DroneAid-Parts/OpenAIO/research/review-2026-10/lr_img/base_inner.png

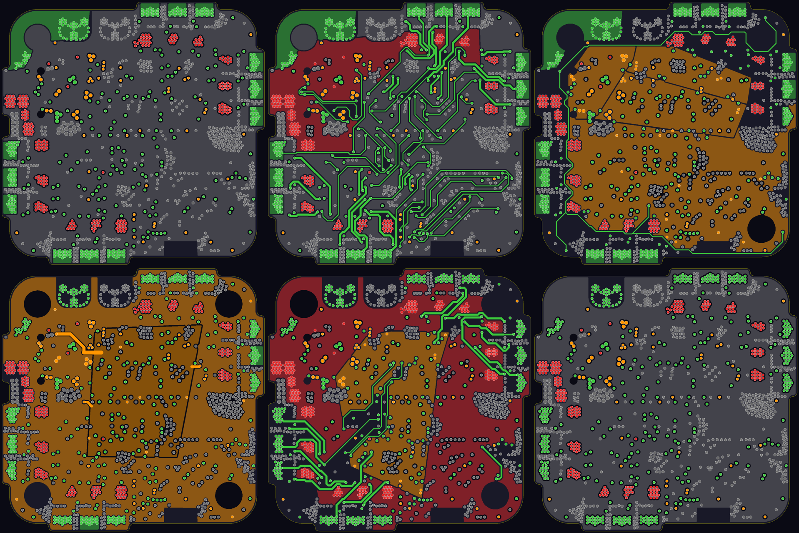
research/review-2026-10/lr_img/base_inner.png
