DroneAid-Parts/OpenAIO/research/review-2026-10/lr_img/core_all.png

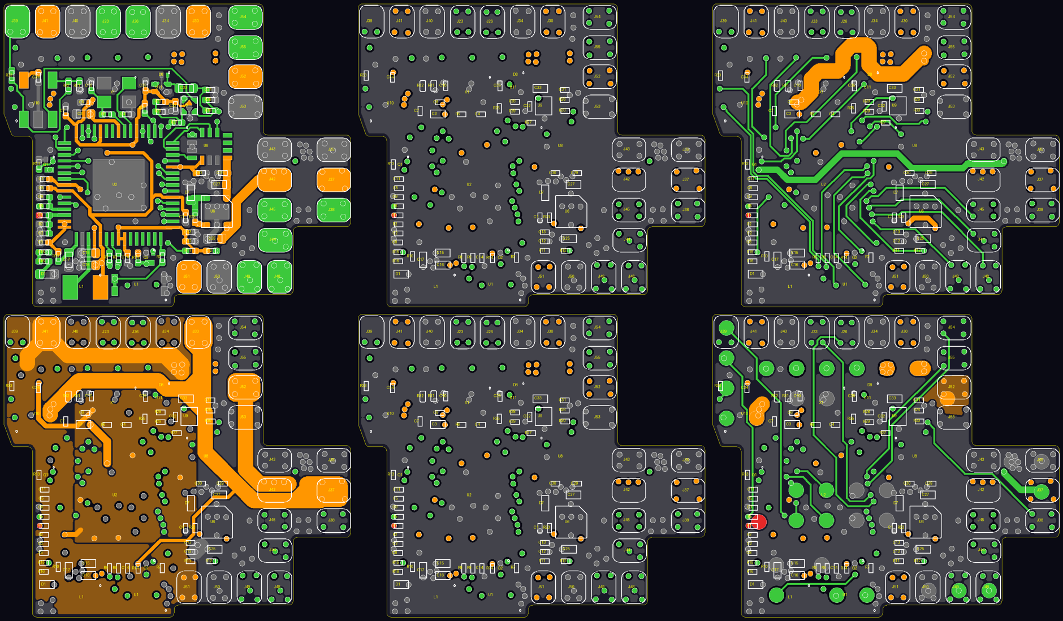
research/review-2026-10/lr_img/core_all.png
