DroneAid-Parts/OpenAIO/research/review-2026-10/critique/round1/dfm.md

# OpenAIO critique round 1: DFM and assembly (perspective: dfm)

Commit 1522ed6 (board files identical to f512434: `git diff --stat f512434 1522ed6 -- hardware` is empty). Both boards were refilled in a private copy with their own .kicad_pro and .kicad_dru. Scripts and outputs are in `scratchpad/critique/dfm/`: `dump.py`, `gaps.py`, `wrl.py` (exact VRML face projection), `paste.py`, `ep.py`, `tomb.py`, `lga.py`, `fid.py`, `edge.py`, `outside.py`, `under.py`, plus `out/drc_*.json`.

## Verdict

1. **Not orderable as is: 1 BLOCKER.** The TF socket Card1 stands under the Core's lower-left corner, so the Core cannot sit flat on J90.
2. **9 MAJOR problems block a clean NextPCB turnkey order**: FET land does not match the BOM MOSFET, fine-pitch stencil apertures too small, starved LGA joint, +BATT 0.16 mm from LGA signal pads, systematic 0201 tombstone risk, Core fiducials off-board, Core missing from the Base BOM/CPL, R34 under Card1, no legal tab sites for panelization.
3. **What passes:** fab rules (track/space, drill, ring, hole-to-hole, edge, VII fill+cap in board setup), BOM MPN coverage and second-side masses all pass apart from the known items.

Counts: BLOCKER 1, MAJOR 9, MINOR 12, NIT 3.

## Findings

| ID | severity | board/layer | location (ref, net, x,y) | evidence | fix |
|---|---|---|---|---|---|
| DFM-01 | BLOCKER | Base F + Core | Card1 (TF-021B-H265) at (67.72,65.92) r-90. The Core corner covers Base (69.19-70.82, 59.995-60.70), and the Core notch edge runs at x=70.77 for y 60.67-71.67 | Datasheet `TF-021B-H265.pdf` p.1-2: body 11.35±0.15 x 5.50±0.15 x 2.5 mm, with the 5.5 including a shell tab past the contact row. The placed `lib.3dshapes/TF-SMD_TF-021B-H265.wrl` has bbox x 65.32-70.82, y 59.995-71.345, z to 2.45. The Core outline maps to Base coordinates through the J91 to J90 offset (-34.232,+8.374); all 46 pads coincide with 0.000 mm error. Model faces above z 0.12 mm inside the Core outline: **1.03 mm² at the socket's pin-8 end, up to 1.64 mm deep**, plus 0.57 mm² along the notch (0.05-0.24 mm). The datasheet drawing puts the tab only 2.65-9.3 mm from the pin-8 end. Even then, the 4.6 mm main body ends at x≈69.92, while the Core corner sits at x 69.19-69.64, so the overlap is still 0.3-0.7 mm. The notch follows Card1's silk (x=69.25/70.14), which is drawn about 0.7 mm inside the real body. The Core floor sits about 0.05-0.07 mm above Base F. | Rework the corner. Options: move Card1 about 0.8 mm toward -x (pad 9 then needs USB1 nudged), or trim the Core corner and notch to clear the datasheet outline by ≥0.3 mm (Core U10 pads are about 0.5 mm from that corner). Then redraw the Card1 silk and courtyard from the datasheet, run `core_model.py`, and check the Base 3D view as AGENTS.md requires. |
| DFM-02 | MAJOR | Base F | R34 (FLASH_CS pull-up, 0201) at (69.975,70.90) | The socket model's underside faces (z -0.05) cover R34's whole body (0.24 mm² of face area over a 0.18 mm² body). By the datasheet, the main body edge at x≈69.92 still overlaps R34's body (x 69.825-70.125). The d81e559 review flagged this (LAYOUT_REVIEW 5.1) and it is unchanged. Card1 would rest on R34 and lift its contacts. | Move R34 ≥0.3 mm clear of the socket outline (x >71.1 is under the Core, so go -y or to B). |
| DFM-03 | MAJOR | Base F+B | All 24 Q (DOY180N03T), e.g. Q21 (88.67,58.53) F, Q16 (84.92,45.66) B | Footprint `Package_SON:Diodes_PowerDI3333-8`: drain land 1.71 x 2.37 mm main area, 0.75 mm from the source pads. BOM part `DOY180N03T.pdf` p.6, TDFN3333-8PL: EP L 2.75 x H 2.15, 0.35 mm (H1) from the source leads. **The land covers 69 % of the package EP on all 24.** The uncovered 0.40 mm strip on the source side lies over foreign copper under mask only: GND under the +BATT EP of Q21 (0.56 mm²), and GND (source) under the phase EP of 10 of the 12 low-side FETs (0.06-0.52 mm² each). | Draw a TDFN3333-8PL land from the datasheet (EP ≥2.15 x 2.75, about 0.35-0.40 mm to the source pads) and pull foreign pours out from under the EP. Alternatively, buy a real PowerDI3333-8 part. Regenerate the stencil. |
| DFM-04 | MAJOR | Core F, Base B | U2 RP2354A QFN-60 (110.71,55.52) Core. U13/U15/U17/U19 AT32F421 QFN-28 Base B | Board-level paste margin is -0.02 mm and -8 % **per axis**, and no fine-pitch footprint overrides it. A 0.2 mm pin pad therefore prints a 0.128 mm aperture: U2 0.695 x 0.128, AT32 0.422 x 0.128. At NextPCB's 0.10 mm stencil for 0.4 mm pitch, the area ratio is **0.54 (U2, 55 apertures) and 0.49 (AT32, 72 apertures)** against the IPC-7525 minimum of 0.66, and the aspect ratio is 1.28 against 1.5. Also below 0.55: Q1/Q2 DFN 0.51, D8 0.40, U11 0.42, FL1 0.53. The KiCad 0201s are fine because they carry their own paste pads (0.318 x 0.36, AR 0.84). EP coverage is 0.68-0.71. | Set the board paste ratio to 0 (keep -0.02 or 0), and put reductions only on EPs and large pads through footprint-level margins. For 0.4 mm-pitch pins use 1:1 apertures, which gives AR 0.78 at 0.10 mm. Recheck with `paste.py`. |
| DFM-05 | MAJOR | Base F J90 / Core B J91 | LGA, J90 origin (80.25,61.65); 46 pads at 1.0 mm diameter on a 2.0 mm pitch | J90 paste margin is -0.10 mm, giving a 0.80 mm aperture (64 % of the pad). J91 has no paste. Solder per joint at a 0.10 mm stencil is about 0.025 mm³ over a 0.785 mm² pad, so the joint is about **0.03 mm high**. The pad array diagonal is 23.3 mm, and IPC bow/twist of 0.75 % allows 0.17 mm across it. Core copper balance is F 72 % against B 86 % and In2 74 % against In3 81 %. The stackup sums to 0.90 mm (see DFM-16). A Core that bows by a few tens of µm leaves the corner joints open. | Print 1:1 or a 1.1:1 overprint on J90 with a 0.12-0.15 mm step stencil, or pre-bump J91 during the Core build. Put Core warpage ≤0.05 mm on the order (ask NextPCB), and balance the Core B pour. |
| DFM-06 | MAJOR | Base F.Cu (and Core B.Cu) | J90 pads 4 (+4v5), 8 (CURR), 10/20 (SWDIO/SWCLK), 12/13/17 (SPI0), 19/21/23/24 (MOTOR1-4), 22 (+5V), 25/33 (UART1), 34 (BUZZER-) | The +BATT F.Cu pour is **0.16 mm** from 15 non-GND LGA pads (29 pads under 0.3 mm in total). On the Core, the B.Cu GND pour is 0.105 mm from 25 J91 signal pads. Both sides have 0 mm mask expansion (see DFM-12), and a solder ball or mask sliver here cannot be seen or reworked. Decision D2 asked for ≥0.3 mm +BATT clearance around J90 and is not implemented. | Add a DRU rule: +BATT zone to J90 pads ≥0.30 mm (and GND to J91 signal pads ≥0.2). Refill, then rerun the DC solver. |
| DFM-07 | MAJOR | Core F, Base B | e.g. Core C10 (108.91,48.95): GND end has a via in pad and 0.77 mm² of pour, the other end 0.03 mm². Base C65 (84.83,76.40), C67 (90.69,71.80), R38 (67.35,61.53) | 0201 parts with a via in the pad at **one end only**: Core 30 of 43, Base 76 of 135. Of those, 15 (Core) and 33 (Base) also have ≥4x attached-copper asymmetry within 0.6 mm. 0402: 7 of 11 (Core) and 13 of 19 (Base). Pours connect pads solid (`connect_pads yes` on 3 of 4 Core zones and 43 of 48 Base zones), and the VII via ties the pad straight into the inner GND planes. This is a classic tombstone recipe. | For 0201/0402 GND pads use thermal-relief zone connection (pad-level override), or put a via in both pads, or dog-bone the GND via. Prioritise the 48 parts that have both conditions (`tomb.py`). |
| DFM-08 | MAJOR | Core F | FID1 (104.10,62.35), FID2 (124.30,61.60), FID3 (123.20,45.40) | All three Core fiducials are **outside Edge.Cuts**, 0.9 / 2.0 / 2.9 mm beyond the edge (their copper reaches 1.4-3.4 mm out). CAM will remove them, leaving 0 board fiducials for a 0.4 mm QFN-60, 0201s and two X2SON parts. DRC does not catch this because the copper is more than 0.2 mm from the edge. | Move the fiducials inside the outline: 3 asymmetric spots in the Core F free area (about 83 mm²), 1 mm copper with a 2 mm opening, ≥1 mm from copper. Panel fiducials alone are a fallback. |
| DFM-09 | MAJOR | Base BOM/CPL | J90 (80.25,61.65) | J90 is `exclude_from_bom` and `exclude_from_pos_files` (dump), and no other line stands for the Core. A turnkey Base order then has no BOM line or centroid for the Core PCBA. The Core's top is fully populated; U2 (the flattest pick surface) sits about 3.9 mm off the outline centre. | Add a BOM line "OpenAIO-Core PCBA (consigned, C)" plus a CPL row (J90 origin, rotation, side F) and a pick-point note. Confirm NEXTPCB.md question 4.6-1. |
| DFM-10 | MAJOR | Base and Core edges | Base perimeter 131.3 mm, Core 84.3 mm | NextPCB needs a panel (both boards are below the 50 x 50 minimum) with mouse-bite tabs ≥5 mm wide and parts ≥3 mm from a tab. Edge with no pad or body within 1.0 mm: **Base 2.2 mm in total (longest 1.25), Core 3.2 mm (longest 1.0)**. Within 0.5 mm: Base longest 2.75 mm at x=91.9, y 65.1-67.6; Core 11.75 mm on its bottom edge and 5.5 mm on the left diagonal. Other edge conditions: Base pads cross the edge on every side (DFM-22). USB1 overhangs 1.1 mm (model) and U12 0.49 mm. B-side Q16/Q26/Q20/Q8/Q10 bodies are 0.09-0.19 mm from the edge and FL1 0.01 mm. Core R13 is 0.24 mm and Core edge pads line 3 sides. Base F parts sit 0.34-0.45 mm from the Core outline (JP1, C105/C106, U12, Q21, Q13), which leaves no room for mouse-bite nubs on those Core edges. | Agree the panel with NextPCB before ordering: tabs only at the measured free runs (Core bottom and diagonal; Base right edge x=91.9), solid frame and post-assembly router depanel, or a KiKit panel with a slot ≥2.5 mm at USB1. Sand the Core nubs facing JP1, C105/C106 and Q13/Q21. |
| DFM-11 | MINOR | Base F | L3 (66.675,54.125) / U25 (67.15,51.55); C104 (67.75,50.15) | This pair and R34/Card1 are the source of the reported "F P10 0.000". L3 is 3.0±0.1 (`XRTC303020D4R7MBCA.pdf` §3) and U25 is SC70 2.00 x 1.25 nominal (`INA186A3IDCKR.pdf`). Nominal edges: L3 at y=52.625, U25 at y=52.55, a **0.075 mm** body gap. At maximum tolerance they overlap by about 0.05 mm (model overlap 0.027 mm²). | Move U25 and C104 0.2 mm toward -y (or L3 toward +y). |
| DFM-12 | MINOR | Both, mask | Board setup | `pad_to_mask_clearance 0` on both boards. NextPCB asks for ≥0.04 mm expansion, so its CAM will grow the openings. The Core has no `solder_mask_min_width` (Base has 0.09). With 0.04 / 0.09 set: Core loses the dams on U9 (5) and U11 (4); Base on U23 (2), C19-U25, R64/R65/R66/C45, R57-R83, and FID1/FID2 openings touch neighbouring pads. | Set the mask web to 0.09 on the Core and the expansion to 0.04-0.05 on both, then rerun DRC. Gang U9/U11/U23 deliberately and say so in the order. |
| DFM-13 | MINOR | Core F, Base B | Core C32-U9 0.150, R13-Q1 0.17, U6-R23 0.189, C5-C9/C8-C2 0.195. Base B R20-Rsense2 0.128, R65/R66/R64/C45 0.155, 25 0201 pairs at 0.175 | Fab-body nearest-neighbour gaps: Core F median 0.230 / P10 0.189, 8 real pairs under 0.20 (C34-U10 0.000 is a false positive: lead-to-body 0.4-0.6 mm). Base B median 0.325 / P10 0.175, 32 pairs under 0.20. NextPCB's 0201 guidance is 0.20-0.25, so expect DFA questions. | Accept them in the DFA review or open the 0.128-0.155 pairs to ≥0.20 (R20 against the 2512, the R64-R66 cluster). |
| DFM-14 | MINOR | Base F, B / LGA | J90 area | 2D X-ray: 37 of 46 LGA joints overlap other solder in plan, 21 from Base B parts (U15/U16/U17/U19/U20/U21, D2-D4) and 28 from Core F parts (U2 EP, U8, U6, X1, ...). NextPCB's default 2D X-ray cannot resolve them. | Ask for 2.5D or oblique AXI on first articles and add a firmware test that toggles all 46 LGA nets (SWD is on the LGA). |
| DFM-15 | MINOR | Base F, Core B silk | J90 pin-1 circle 0.13 mm², Card1 silk lines, "-" label at (71.0,53.6), J91 B.Silkscreen circle | Silk ink (10-20 µm) under the Core, against a joint about 30 µm high (DFM-05). | Delete silk inside the Core outline on Base F and all silk on Core B. |
| DFM-16 | MINOR | Core stackup | Board setup | The board says 0.8 mm, but the stackup sums to **0.90 mm** (inner Cu 0.035 = 1 oz; JLC dielectrics 0.0994/0.11/0.25). The Core DRU assumes NextPCB `6L-0.8mm-0.5oz-1080` with 0.5 oz inner: its 0.076 inner rule is invalid at 1 oz, and NextPCB publishes no 1 oz inner at 0.8 mm. | Enter the NextPCB 6L-0.8 stack (0.5 oz inner) or fix the DRU. Order a customer-specified stack for the Base (non-standard 0.1/0.3 pairing; NEXTPCB.md 1.1). |
| DFM-17 | MINOR | Both | Stackup `copper_finish "None"` | Finish is unspecified. HASL is not flat enough for 0.4 mm QFN, 0201, the X2SONs and a thin-joint LGA. | Set ENIG in both stackups and on the order. |
| DFM-18 | MINOR | Base F | L2 (66.665,57.65), L3 | `lib.pretty/IND-SMD_L3.0-W3.0_AFE303020S` has `(attr through_hole)`, although both pads are SMD. `footprint_type_mismatch` is set to ignore, so DRC stays silent. With `--smd-only` or toolkit THT handling, these lines are dropped or quoted as THT. | Change the attribute to SMD in the library and update the footprints. |
| DFM-19 | MINOR | Core BOM | Q1 (106.11,54.17), Q2 | The AP1606 line says Manufacturer "Diodes Incorporated". The library datasheet for the same LCSC C2849580 (`datasheet/AP1606.pdf`, manifest) is All Power Semiconductor. Mixed names elsewhere: "TI(德州仪器)" against "Texas Instruments", "Raspberry Pi(树莓派)", "JOHANSON(约翰逊)". | Correct the manufacturer and normalise the names to the English legal names. |
| DFM-20 | MINOR | Base, edge pads | U24 pads (battery and motors), J15-J33 | Pad copper outside Edge.Cuts: **U24 F 79.6 of 201 mm², B 37.1 of 73 mm², up to 4.30 mm beyond the edge**; J pads 35-47 % outside, up to 1.08 mm. The DRU marks these pads as intended. CAM will clip them and may pull copper back 0.2-0.4 mm. The router runs through 2 oz copper. | Put an order note ("copper to the routed edge intended, no pull-back"), or pull the pads back 0.2 mm inside. Check the pad area left for the battery leads. |
| DFM-21 | MINOR | Base B | FID1 (59.90,48.71), FID2 (63.20,45.41), FID3 (59.90,72.81) | Base F (the second side, with the LGA land, USB-C and 0201s) has **no fiducials**. The three B fiducials lie in a strip 3.3 mm wide in x (27.4 mm in y), which gives poor x-scale and rotation correction. | Add 3 F fiducials and spread the B set to opposite corners (≥1 mm from copper). Otherwise rely on rail fiducials. |
| DFM-22 | MINOR | Both | Board setup | VII fill and cap is a board default, and every via inherits it: 1340 Base and 251 Core vias, all mode "from board". Excellon and Gerber output does not carry that requirement. | Put "IPC-4761 VII on all vias" in the order and fab notes, or limit VII to in-pad vias if NextPCB prices it per via. |
| DFM-23 | NIT | Both CPL | FID1-3 (both boards), TP1-TP8 (Base) | Excluded from BOM but not from pos, so the CPL has rows with no BOM line and NextPCB will raise an EQ. | Exclude them from pos files. |
| DFM-24 | NIT | Core | 4 clearances 0.083-0.085 (B/F), 4 tracks 0.08 | These are the only Core items below 0.09 (3.5 mil); everything else would pass a 0.09/0.09 standard tier. | Widen them to 0.09 if NextPCB prices 3 mil and 3.5 mil differently. |
| DFM-25 | NIT | Base B | U22 ESP32-C3 EP | EP paste coverage is 46 %; the other EPs are 63-71 %. | Raise it to about 60 % if voiding shows up on X-ray. |

## Already known (confirmed still holding)

- **FET stacking:** 12 high-side FETs on F and 12 low-side FETs on B, mirrored, so the exposed pads overlap for X-ray. Unchanged.
- **Original edge defects:** DRC `copper_edge_clearance` 4: JP1.1 0.000, U12.7/.8 0.000, FL1.2 0.010. Core D1.2 is no longer flagged.
- **Dangling vias:** Core `via_dangling` 28, Base 1.
- **Base vias:** Base vias are 1296 x 0.35/0.20, 42 x 0.50/0.30 and 2 x 0.45/0.25 (ring 0.075, owner-confirmed). Core vias are 251 x 0.35/0.15.
- **Base clearance errors:** now 16, down from 17. All are inner-layer gate tracks and U24.11 at 0.0898-0.090 against the 0.10 rule.
- **Rsense2:** still has no Manufacturer. It is the only placed part missing one; the 67 Core and 226 other Base BOM parts all have Manufacturer and MPN.
- **Second-side masses:** checked, no finding. Base B is the first reflow side, so its parts hang during the F reflow. The worst is DSK24 at 0.015 g on 2.18 mm² = 6.9 mg/mm² (datasheet weight). Estimates for the others: Q 6.06 mm², Rsense2 8.09 mm², U22 9.75 mm². All are far below 46 mg/mm².
- **Fab rules:** track/space checked against the NextPCB tiers on a probe DRU, no new finding. Base outer is ≥0.14 (2 oz extreme tier) and inner ≥0.10 apart from the known 0.09 items. Hole-to-hole (0.30 different net), hole clearance and edge clearance are clean apart from the known items.
