DroneAid-Parts/OpenAIO/research/review-2026-10/critique/round1/power.md

# Power and thermal critique (round 1): OpenAIO at 1522ed6 (board files as of f512434)

**Verdict**
- No BLOCKER. The power stage is sound: each of the 12 legs has its own 0805 bypass cap 0.27-0.39 mm from the stack, with 17-19 phase vias. The shunt path is short (/CSA+ 0.134 mOhm) and the INA186 sense lines are truly Kelvin (-IN pick-up is 0 mOhm/A for all 12 drains).
- 3 MAJOR: both buck FB nodes are routed against LMR51430 §9.4.1.2; the +5V rail runs on 0.25-0.30 mm inner tracks with vias at 2.2 A; 2S is still outside the NSG2065Q recommended VCC. 9 MINOR, 1 NIT.
- The LAYOUT_REVIEW +BATT target (0.387 mOhm mean) is not met: the board measures 0.581. GND is close to its target (0.359 vs 0.325). The thermal model gives about **20 A per motor continuous** (all 4 motors, 120 C board, good airflow). 30 A is burst only, about 10 s.

Method: the `lr_dc.py` solver (h 0.05 mm, refilled zones, 20 um via plating, stackup from the board: F/B 70 um, In 35 um, In3-In4 0.23 mm) on fresh dumps of both boards. Scripts and outputs are in `critique/power/` (`pw.py`, `kel.py`, `checks.py`, `fb.py`, `whatif.py`, `jmap.py`). R means 1 A alone, source to sink. Coordinates are Base coordinates.

## Findings

| ID | severity | board/layer | location (ref, net, x,y) | evidence | fix |
|---|---|---|---|---|---|
| PW1 | MAJOR | Base B, In2 | U4 FB (68.1,55.5), R19/R20 (63.7,54.95)/(63.75,54.05); U3 FB (64.31,57.0), R17/R18 (68.62,58.75)/(68.62,60.1) | The FB dividers sit 4.3-4.4 mm from the FB pins, so the 12-14 kOhm FB node is the long trace. **U4:** FB copper is 0.16 mm from U4-SW copper on the same layer (B) at (68.36,56.03), with 0.68 mm2 of FB copper within 0.5 mm of SW. **U3:** the FB track on In2 is 0.10 mm from the SW via annulus at (65.95,58.18). LMR51430 §9.4.1.2 (p22): divider close to FB, sense trace away from SW/L, with a GND layer between. | Put R17/R18 within 1 mm of U3.4 and R19/R20 within 1 mm of U4.4. Route the low-impedance VOUT sense to them instead. Keep at least 0.5 mm, with In6/In3 GND, between FB and SW copper. |
| PW2 | MAJOR | Base In1/In2/In3, vias | +5V from L3.2 (65.72,54.12) | The 3 A buck output is carried only by 0.25-0.30 mm 1-oz tracks on In1/In2/In3 (35.6 / 32 / 5.5 mm), and those tracks also cut the GND planes. Scenario: Core 1 A + D2 0.7 A + 5 pads x 0.3 A = 3.2 A. Vias at 2.2 A each at (69.75,52.45), (71.8,49.87) and (71.8,50.92); 7 vias above 1 A. R L3 to J90.6 is 23.1 mOhm, to J90.22 36.2, to J25 63.3; worst drop 75 mV. Narrowest cut 0.0087 mm2 (one 0.25 mm In2 track). | Add a +5V pour on B or F (≥ 1 mm neck) from L3 to J90.6/.22 and the pads. Use ≥ 4 vias per layer change (≤ 0.75 A/via). Take +5V off In1/In3. |
| PW3 | MAJOR | schematic / Base | U14/U16/U18/U20 VCC (+10V); U3 | 2S is still outside spec (CIRCUIT_REVIEW S1 is open). NSG2065Q §8.5 recommends VCC 8-20 V and VB ≥ VS+6 V. With +10V always on, U3 is in dropout at 2S: VCC ≈ VBAT − 0.2 = 6.0-8.2 V, and VBS about 5.3-7.6 V with 100 nF boots (C40 CL05B104KB54PNC), only 0.4-1 V above the 4.9 V max UVLO. README states no input range. The task header says 2-6S. | Declare **3S-6S** in README/AGENTS, or for 2S add a boost for VCC and go to 220 nF/25 V bootstrap caps (O11). |
| PW4 | MINOR | Base, all layers | +BATT, Rsense2.2 to 12 HS drains | The plan numbers do not hold. Measured mean 0.581 mOhm, worst Q21 0.797; LAYOUT_REVIEW §3.6 predicted 0.387 / 0.541. The 80 A phase-A loss is 1.84 W (predicted 1.29). Vias above 2 A: 4 (predicted 1). Hottest via 3.36 A at (83.30,61.25), 0.8 mm in plan from the IMU U8 (82.5,61.3); its dissipation is about 20 mW, so no thermal issue. Causes: the In5 +10V island (180 mm2) leaves +BATT only 42 % of In5, In4 is 61 % (743 mm2) and perforated, and F +BATT is 332 mm2 in pieces. What-if: giving the In5 island back to +BATT gives 0.503 / 0.669 mOhm, 1.63 W, top via 2.44 A. The rest of the gap is the known 21 nets and via antipads. | Shrink the +10V island to a 1.5 mm In5 corridor (1.5 A). Add 4-6 +BATT stitching vias around (83.3,61.25). Update the §3.6 numbers in PLAN/LAYOUT_REVIEW. |
| PW5 | MINOR | schematic / Base B | C43/C50/C57/C64; U14.4 (1 via), U16.4 (0 vias within 1 mm), U18.4, U20.4 | CIRCUIT_REVIEW S7 was deferred in b3d1592 and is still not done. VCC has only 100 nF 0201 (GRM033R6YA104KE14D, about 55 nF at 10 V), so each LS turn-on (Qg 39.8 nC) dips VCC about 0.7 V. Each VCC hangs on a single 0.2 mm via: path 3.5-7.5 mOhm, cut 0.0126 mm2 (one barrel). | Add 1 uF 25 V 0402 (CL05A105KA5NQNC) at each VCC pin and a second via. |
| PW6 | MINOR | schematic | C23 (+10V), C24 (+5V) | CIRCUIT_REVIEW S8 was deferred. +10V output is 1 x 22 uF 16 V 0603 X5R (CL10A226MO7JZNC), about 5-7 uF at 10 V. LMR51430 Table 9-2 (1.1 MHz, 12 V) gives 3 x 10 uF/25 V, and Eq. 14 for a 1.5 A VTX step at 5 % needs ≥ 10.9 uF. Estimated undershoot about 1.1 V. L2 is 4.7 uH against the table's 6.8 uH, so ripple is 1.17 A p-p at 25 V in. | Add a 10-22 uF 25 V 0805 at U3 and verify with a 0 to 1.5 A step. |
| PW7 | MINOR | Base B/F | U4 VIN (68.1,53.2), GND (66.2,53.2) | The nearest 4.7 uF input cap is C19 on the other side (F, 70.03,50.30), 6.1 mm pin-to-pad. Only C107 100 nF is local (1.9 mm). U4.1 GND has no via within 1.0 mm. LMR51430 §9.4.1 asks for CIN as close as possible, grounded on a local top-side plane. U3 is fine (C18, 0.73 mm). | Move a 4.7 uF 0805 onto B beside U4.3/U4.1. Add 2 GND vias at U4.1. |
| PW8 | MINOR | Base | U23.1 (+3V3), U23.4, J90.3/.4 (+4v5) | Single points of failure. U23 OUT feeds the whole RX/ESC +3V3 rail through **1 via** (LAYOUT_REVIEW #10, still open). U23 IN has no via within 1 mm, and its path is 32 mOhm over a 0.20 mm In2 track. Both Core +4v5 LGA pads hang on **one** Base via at (70.62,55.09), carrying 0.75 A. | Use ≥ 2 vias at U23 OUT and IN, and give J90.3 and J90.4 one via each. |
| PW9 | MINOR | Base vias | LS drain via arrays, motor pads U24.12-23 | Current per via (each LS alone): 1.07-1.24 A at 20 A and 1.6-1.9 A at 30 A, against the 1 A working limit. Motor 4 is the worst (Q22: 17 vias, 1.24 A @ (91.17,57.59)). The HS paths are F only, 0.06-0.09 mOhm. Low-side source GND vias are known (4.52 A @ (80.90,46.69), 18 above 2 A, unchanged). | Accept 20 A continuous, or add VIPPO vias in the LS drain pads (Q22/Q24/Q26 first). |
| PW10 | MINOR | system | 4 x 20 A, 6S, 24 kHz | Thermal budget at full throttle (my model): FET conduction 4.6 W (1.45 mOhm hot, 2 FETs per motor); switching and dead time about 3 W (15 Ohm gate R35-type, Qgd 5.9 nC, 200 ns DT); copper 5.5 W (/CSA+ 0.86, shunt 1.28, +BATT 1.84, GND 1.20, phase 0.36); bucks and logic about 3.5 W. Total about 16.7 W. At an assumed h ≈ 80 W/m2K on both sides of 35 x 35 mm (0.196 W/K), the rise is 85 K, i.e. **120 C at 35 C ambient**. At 4 x 30 A the total is about 31 W: it hits 120 C in about 10 s (board about 3.2 J/K), and the shunt dissipates 2.9 W. The hottest cluster is the left edge: shunt, /CSA+ neck (peak J 812 A/mm2 on B at (65.39,48.68)), U3/U4/L2/L3 and Q3-Q8. The IMU and crystals are ≥ 6.8 mm from any FET; X1 (Core) sits over the AT32s only. | Publish 20 A continuous / 30 A burst. Give Rsense2 a manufacturer and check its derating at 2.9 W. |
| PW11 | MINOR | Base, all FETs | Q3-Q26 DOY180N03T, VDS 30 V (DS p1) | At 6S, full charge 25.2 V plus an estimated about 2 V turn-off overshoot leaves about 2.8 V margin. Overshoot estimate: loop about 2 nH plus package; di/dt about 0.9 A/ns at 30 A with 15 Ohm gate resistors. Regen and long battery leads with no external bulk cap can eat that margin. The on-board bulk is 17 x 4.7 uF 50 V X5R 0805, about 1.3 uF each at 25 V. | Require a ≥ 35 V low-ESR electrolytic (≥ 220 uF) at the battery pads in the README, or use 40 V FETs for 6S. |
| PW12 | MINOR | USB-only | U13/15/17/19 to NSG2065Q HIN/LIN, direct (no series R) | On USB only, +4v5/+3V3 power the 4 AT32s while +10V (NSG2065Q VCC) is 0 V. VIN abs max is VCC + 0.3 V (NSG2065Q DS abs max table). Any AM32 output high (brake-on-stop, beacon) back-feeds VCC/+10V through the input ESD. No other back-feed: D2 blocks +4v5 to +5V, and +BATT/+5V/+10V stay off. USB to D3 is 16 mOhm. | Firmware must keep all xIN/LIN low when VBAT is absent, or add 1 kOhm series resistors at the driver inputs. |
| PW13 | MINOR | Base In2 | /CSA+ track from the +IN tap via (65.54,50.78) to (75.02,50.84) | A 10 mm, 0.25-0.30 mm dangling stub at battery potential on In2, with no pad or via at its end. It is an antenna on the INA186 +IN. The Kelvin itself is good: +IN sits −1.24 mV (−7.7 %) from the pad-1 mean at 80 A, which is a constant and calibratable error. | Delete the stub. |
| PW14 | NIT | Base F/In3/B | CURR, U25.6 to J90.8 | 14.3 mm, 3 vias. It runs on In3 (the GND plane) at (65.25,52.23)-(70.55,51.68) and passes 0.67 mm from the U4/L3 SW copper. The source is low impedance and R5 1k / C9 100 n (1.6 kHz) filters at the ADC, so the impact is low. The INA186 runs from Base +3V3 and the ADC from Core +3.3V; the output is not ratiometric, so that is fine. | Move it off In3 onto In2/In5 under GND during the finish pass. |

## Already known (confirmed still holding)
- LS-source GND via crowding with stacked FETs: 4.52 A at (80.90,46.69); 18 vias above 2 A and 9 above 3 A at 4 x 20 A. GND mean is 0.359 mOhm, worst Q12 0.478 (plan 0.325 / 0.431), loss 1.20 W.
- U3 has no HF 100 nF cap. U4 has C107 (1.9 mm).
- The 21 nets on the In4/In5 +BATT planes explain most of the +BATT gap after the PW4 what-if.
- +10V is always on with battery (9aba717). At 2S it follows the pack: see PW3.
- Rsense2 has an MPN (ASR-S-3-0.2F) but no manufacturer. The shunt itself is unchanged.
