DroneAid-Parts/OpenAIO/research/review-2026-10/critique/round1/visual.md

# Visual and owner-rules review, round 1 (commit 1522ed6, boards as of f512434)

## Verdict

FAIL on owner silkscreen rules and on schematic visual quality. 0 BLOCKER, 12 MAJOR, 7 MINOR, 4 NIT.
The Core pad labels cannot be read (they overlap each other, sit on pads and are clipped by the edge), 32 user solder pads have no label, and the Base 'LED' polygons are corrupted. Neither board carries a revision or date, and the Core has no name.
The root, fc_power and fc_rp2350a sheets have stacked symbols and overlapping text. DRC still reports 41 silk errors (Core 14, Base 31), and the project files set silk_overlap and missing_courtyard to "ignore".

Method: I ran `kicad-cli pcb render` (basic, 1600x1200 and 4000x3000) on both sides and looked at the PNGs. I also ran commons `silk_check.py` (Core 88 hits, Base 297) and `sch_visual_check.py`, which reports 13723 hits; I counted only what the PDF plot shows. Other checks: `kicad-cli pcb drc --severity-all` on a scratch copy, pcbnew queries and the schematic PDF at 300 dpi. Scripts and images are in `scratchpad/critique/visual/`.

## Findings

| ID | severity | board/layer | location (ref, net, x,y) | evidence | fix |
|---|---|---|---|---|---|
| V1 | MAJOR | Core F.Silk | 13 gr_text at x 118.06-123.83, y 44.86-60.0, plus 'VTX' (104.9,45.72) / 'gnd' (114.93,45.69) / '5v' (116.59,45.73) | The labels are unreadable. silk_check finds 7 text-text overlaps: R1/4v5, RP0/4v5, RP0/tp0, gnd/4v5, gnd/5v (2x), cam/5v. Labels at a 2.0 mm pitch at 1.2 mm height run together: the render reads "tp0RP040v5gnd" and "cam5vgn". DRC: 12 silk_over_copper (labels over J30, J43, J53, J44, J45, J35) and 2 "Silkscreen clipped by board edge". 'VTX' is rotated 180 deg and its X falls off the 103.05 edge; 'gnd' and '5v' are also upside down. The label codes do not match the pad values: t1≠TX1 (J54), R1≠RX1 (J55), tp0/RP0≠PIO_TX0/PIO_RX0 (J44/J45), and gnd/5v/4v5/cam are lowercase where the values are GND/5V/4V5/CAM. 562c589 deleted 4 labels for owner re-placement; the 13 that remain are themselves illegible. | Re-place one code per pad (3 characters max, same as the pad value), all horizontal or all at 90 deg, at least 0.15 mm from pads and 0.2 mm from the edge. Set silk_overlap to error. |
| V2 | MAJOR | Base F/B, Core F | Base U24.12-23 (/1A../4C motor pads, x 58.4 / y 77.91 / y 43.91 / x 92.4); J41 +10V (75.7,73.35), J51 GND (75.7,74.9); TP31 SWDIO (78.32,55.15), TP32 SWCLK (79.58,61.41), TP1-TP8 Net-(U13..U19-PA13/PA14), TP9 /RX/BOOT (79.7,67.7); Core J23 SCL, J26 SDA, J40/J50/J53 GND, J48 RX0, J49 TX0 | 32 solder pads have no function label (owner rule: every solder pad has a legible label). There is no silk text within 3 mm of the 12 motor pads, and no motor number or direction arrow anywhere. Of the two VTX pads beside SH-6, only the connector name 'DJI' is printed. B.Silk has only 'B+', 'B-' and 'Open', so the 11 test pads on the bottom are unlabeled. TP1-TP8 have value 'TestPoint' and unnamed nets, so the schematic gives no code either. | Add M1-M4 plus A/B/C (or the pad code), 10V/G at J41/J51, SWD/SWC/RST-style codes at TP31/TP32 and ESC n D/C at TP1-TP8, and BT0 at TP9. Give the TPs named nets and values. |
| V3 | MAJOR | Base F.Silk | 'LED' polygon labels at J20 (≈60.0,48.6), J21 (≈63.4,76.4), J31 (≈87.2,45.4) | Each label is 4 polygons: 0.74x0.57, 0.77x0.62, 0.27x0.37 and 0.12x0.19 mm. The E is split into two slivers and the D has lost its stem. Both the KiCad render and a direct pcbnew polygon raster read "C⅃" plus a triangle, not LED. These come from f512434 ("Tokyo polygons at 0.7x or 0.8x"). The 'LED' text label at J32 (90.64,73.78) renders correctly. | Use gr_text 'LED' (embed the font) or re-export the glyphs with their holes intact. Check the result in a render. |
| V4 | MAJOR | Base B.Silk | J33 BUZ+ (net +5V, 91.17,61.61) labelled 'B+' at (88.41,62.2); J29 BUZ- labelled 'B-' at (88.45,64.11) | 'B+' is the usual code for battery positive. Here it marks a +5V buzzer pad on a board whose battery pads are marked +/-, so a 6S lead soldered there lands on +5V. The schematic values are BUZ+/BUZ-, so the silk code and the value disagree. Both labels also sit on 31 vias (19 + 12). | Use 'BZ+'/'BZ-' (the same code in value, silk and docs) and move the labels clear of the via field. |
| V5 | MAJOR | both boards | Core: only a Cmts.User 'TODO brand mark: incutec wordmark...' at (109.9,47.9); Base: only 'Open' (88.5,62.4) and 3 'AIO' polygons (79.6-84.5, 64.8-66.9) on B.Silk; both title blocks empty | No revision or date on either board, and no name on the Core. The Core (R2a, 46-pad LGA) and the Base must be paired by revision, but the boards cannot be matched by eye. Owner rule: incutec wordmark plus OpenDrone mark; both are absent and only a TODO stands in. There is no forward-direction arrow for the IMU board alignment and no motor numbering. | Add name + rev + date to both boards (Core top, in the free area near (109,48)), the brand marks from OpenDrone-Brand, an arrow, and M1-M4. Fill the title blocks. |
| V6 | MAJOR | Base F.Silk | JP1 (90.78,69.28), Card1 (67.72,65.92), USB1 (61.88,55.51), U12 (80.45,75.06); labels '5V' x4, '-', '+' | DRC on the scratch copy reports silk_over_copper 27 and silk_edge_clearance 4, against the owner requirement of 0 DRC errors. Library connector outlines are still present: JP1 11, Card1 10, USB1 8 and U12 3 shapes. Owner rule: connectors get name + pin-1 mark only. These outlines cause 22 of the 27 errors, and the '5V' x4 and '-' labels cause the other 5; and the USB1 outline reaches x 56.70, 1 mm past the 57.70 edge. The '5V' labels sit over J16.1, U24.11 and U24.21 (motor pad 4C), and silk_check also puts '+' over C104.2. U12 has no pin-1 mark: the only asymmetric mark is the library L at the pin-6 end (84.22,73.32-75.89), and pin 1 is at 77.95. | Strip the connector silk (commons strip_silk.py), add a pin-1 dot at U12.1, and move the 6 labels. |
| V7 | MAJOR | both .kicad_pro | rule_severities | silk_overlap, missing_courtyard, text_height and text_thickness are set to "ignore" on both boards, and malformed_courtyard is "ignore" on the Base. The owner requirement of 2026-10-07 says no check is globally ignored. These settings hide the Core label overlaps (V1), 50 functional parts without a courtyard (V8) and the glyph stroke (M2). | Set them to error. Turn each intended departure into a scoped DRU rule. |
| V8 | MAJOR | Base, Core Crtyd | Base 24x Diodes_PowerDI3333-8 FETs (Q3, Q5, Q7, ...), U13/U15/U17/U19 (AT32F421 QFN-28, which have no graphics at all), 5x QFN-24, L2, L3, 2x SOT-23-6; Core U1, U8, U9, U10, Q1, Q2, D8, L1, X1 | 41 functional parts on the Base (the 37 listed plus JP1, USB1, U12 and Card1) and 9 on the Core have no courtyard. That puts the courtyard_clearance 0.20 mm body-to-body DRU rule and courtyards_overlap out of reach for the whole power stage and the ESC MCUs. | Add courtyards (max(body, land) + 0.10, per the commons normalisation) and re-run DRC. |
| V9 | MAJOR | schematic root | OpenAIO.kicad_sch: TP16/TP17 (≈145-152,46); global labels UART0_TX/UART0_RX/FLASH_CS/SPI0 near (≈200,50-110); U25/Rsense area (≈225-275,130-141) | In the PDF plot, TP16 and TP17 are stacked on the same spot and their texts overlap. The vertical labels lie across PIOUART0/UART0 wires, the 'Blackbox' sheet name and the OSD sheet pins. The diagonal +BATT-to-shunt wires (4) are shown at (223.5-236.2,137-141). The GND at U25 REF is rotated 90 deg, the CURR label sits on the frame, and the title block is empty. Checker: text_overlap 159, text_over_wire 71, wire_through_symbol 3 (TP17, TP41). | Move U25/Rsense to the Power sheet, separate the TPs, set the labels horizontal on their own wires, and fill the title block. |
| V10 | MAJOR | schematic fc_power | C19/C107 (≈5V buck input); C26 (198.12,121.92); U7/R24/D6 block | C107 sits on top of C19, so the values read "4.7uF 5000nF". C26 shows its Description field "Unpolarized capacitor" in purple over the cap and its EN wire. U7 OUT is '+3.3V', and the "power LED" R24/D6 drawn next to it is on '+3V3', a different net. Per pcbnew, U7 is on the Core (+3.3V) and R24/D6 are on the Base (+3V3). The LGA spec line 68 says D6/R24 "must move to the Core or be deleted". | Separate C107, hide the C26 description, move R24/D6 to the sheet that powers +3V3 (or delete them), and keep a single 3.3 V name per board. |
| V11 | MAJOR | schematic fc_rp2350a | TP24/TP25 near R8/R9 (USB_D±); TP18/TP19/TP26/TP27 on SPI0 lines; TP10 at (0.76,2.29); USB1 A1 GND at (125.73,270.51) | The 300 dpi plot shows: the TP24/TP25 texts stacked; R8's body over the USB_D- label; the TP19/TP26/TP27 texts written over the SPI0 wires; TP10 outside the frame with a wire dangling at (0.76,7.5); the USB1 A1 ground pointing up; and 9 sideways power symbols. Checker: text_overlap 1155, text_over_symbol 332. | Separate the TPs, place TP10 inside the frame, use an upright GND on a stub (commons rule), and rotate the supplies upright. |
| V12 | MAJOR | docs | README.md (Specifications) | There is no pinout anywhere: no README section and no diagram (owner rule: the pinout lives in the README and a printed pinout diagram). The README specs are stale: "Base 6 layers" (pcbnew: 8 Cu), "34-pad LGA" (46 pads), "Assembly JLCPCB, LCSC basic parts" (NextPCB turnkey), and the branch name. | Add a pinout table and diagram using the same codes as silk and pad values, and update the specs. |
| M1 | MINOR | both, fab layers | Core U2 RP2354A (QFN-60), U11 (X2SON-4); Base U13/U15/U17/U19 (QFN-28), D2/D3 (SOD-123 DSK24) | No F/B.Fab outline or pin-1/cathode mark; U2/U11 have their pin-1 circle only on User.Comments. Silk carries no pin-1 by rule, so the assembly drawing has no polarity for these 8 parts. The LEDs and the other ICs have one. | Add fab outlines with pin-1 chamfer or dot, and a cathode bar. |
| M2 | MINOR | both F.Silk | Tokyo outline-font labels | Glyph stroke measured from the render cache: '-' at h 5.0 gives 0.568 mm and '+' at h 2.0 gives 0.231 mm, so about 0.114 mm at h 1.0 and 0.091 mm for 'DJI' at h 0.8. Both are below the NextPCB 0.12 mm screen minimum (NEXTPCB.md) and the commons 0.13 mm. | Use h ≥ 1.0 with bold, or KiCad stroke font at 0.13. |
| M3 | MINOR | both | `(embedded_fonts no)` | Tokyo is not installed here ("Font 'Tokyo' not found; substituting Inter"). Output relies on render caches, so Gerbers depend on the exporting machine (commons OpenAIO-Whoop lesson). | Embed the font in both boards. |
| M4 | MINOR | Base B.Silk | 'Open' (88.5,62.4, 8 deg), 'AIO' polygons (≈82,65.8) | The 'Open' text sits on 48 vias and 6 tracks, and the 'AIO' polygons sit on 13 vias and 9 tracks (silk_check). The two halves of the name are about 4 mm apart and at different angles, so they read as two marks. | Make one lockup on a via-free area, or move it to the Core top. |
| M5 | MINOR | Base F.Silk, schematic values | J17/J18/J27/J28 value GND, silk '-'; values PIO_TX0, PIO_RX0, BUZ+, SWDIO, SWCLK, BOOT, TestPoint | The silk code and the value differ, and several values are longer than the 3-character code (D82: same code everywhere). | Define one code table and apply it to values, silk and README. |
| M6 | MINOR | schematic | fc_power and fc_rp2350a title blocks: Date 06/06/2026, Rev 2; core_interface: Rev 1, no date; root: empty | The sheets changed in this PR keep June dates and old revisions. | Set rev/date on all sheets. |
| M7 | MINOR | nets | +4v5 (lowercase) vs +5V/+10V; +3.3V (Core) vs +3V3 (Base) | Net-name case and spelling are inconsistent, and the silk copies the lowercase form. The LGA nets match lga_spec.json (0 of 46 differ). | Rename +4v5 to +4V5 and settle on one 3.3 V spelling per rail. |
| N1 | NIT | Base F.Silk | '5V' at 225 deg (63.85,44.37), '-' at 225 deg | The text is upside down for a viewer. | Keep corner labels at 45/315 deg. |
| N2 | NIT | Base F.Silk | '-' (71.0,53.6, h 5 w 10) | The battery minus is a 4.5 x 0.57 mm bar, while the plus is 1.3 mm. | Match the sizes. |
| N3 | NIT | Core B.Silk | J91 pin-1 dot (103.61,43.53) | It sits within 0.2 mm of the edge (silk_check) on a face that is soldered down and never seen. | Move it to B.Fab. |
| N4 | NIT | schematic core_interface | SPI0 bus members at (54.61 / 156.21, 76.2-88.9) | The member labels are written over their wires, and the checker reports 6 wire ends at bus entries. | Lift the labels 0.38 mm. |

## Already known (confirmed, not re-raised)

- Core: 562c589 deleted the 'gnd', 'SCL' and 'SDA' labels under U7 and the 'gnd' at J53 for owner re-placement. Those pads are still unlabeled (V1 and V2 add the rest).
- Edge defects: JP1.1, FL1.2, U12.7/8 and Core D1.2 are unchanged. DRC on the Base shows copper_edge_clearance 4.
- Base clearance errors: DRC reports 16 here; the brief says 17.
- Core via_dangling 28 (wire-pad vias) and the long finish-pass routes are unchanged.
- The LGA net assignment matches lga_spec.json on J90 and J91 (0 of 46 pads differ).
