DroneAid-Parts/OpenAIO/images/back.png

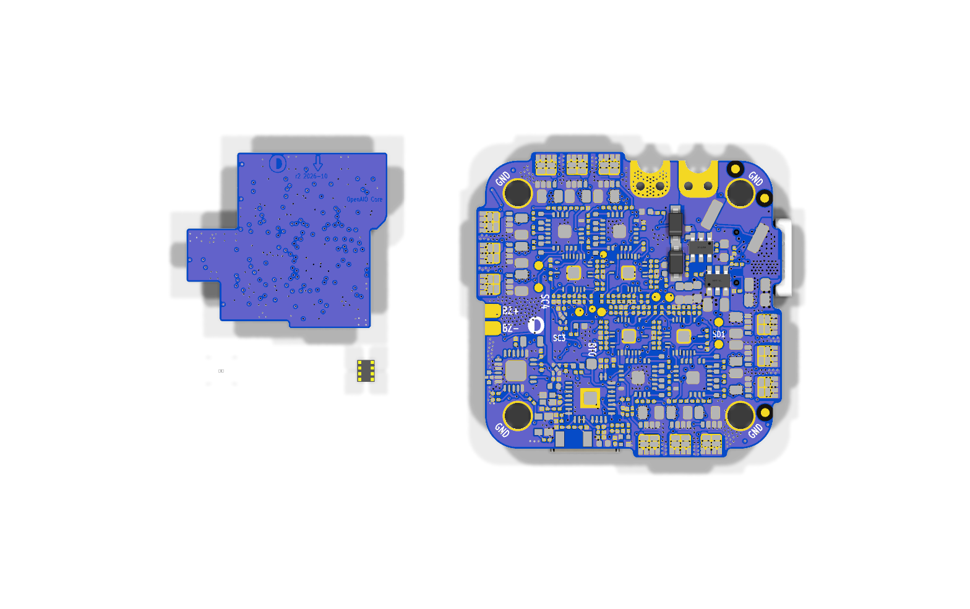
images/back.png
