DroneAid-Parts/OpenAIO/images/front.png

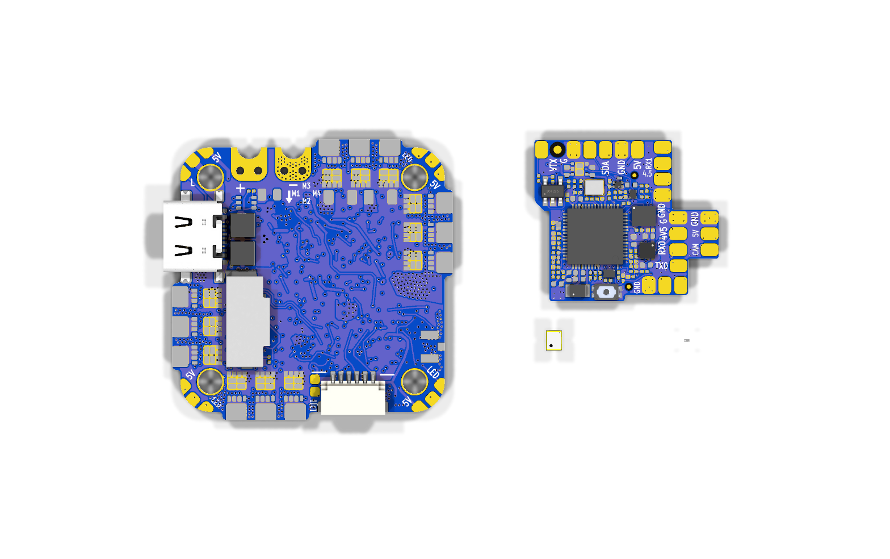
images/front.png
