DroneAid-Parts/OpenAIO/research/review-2026-10/lr_img/base_In3.Cu.png

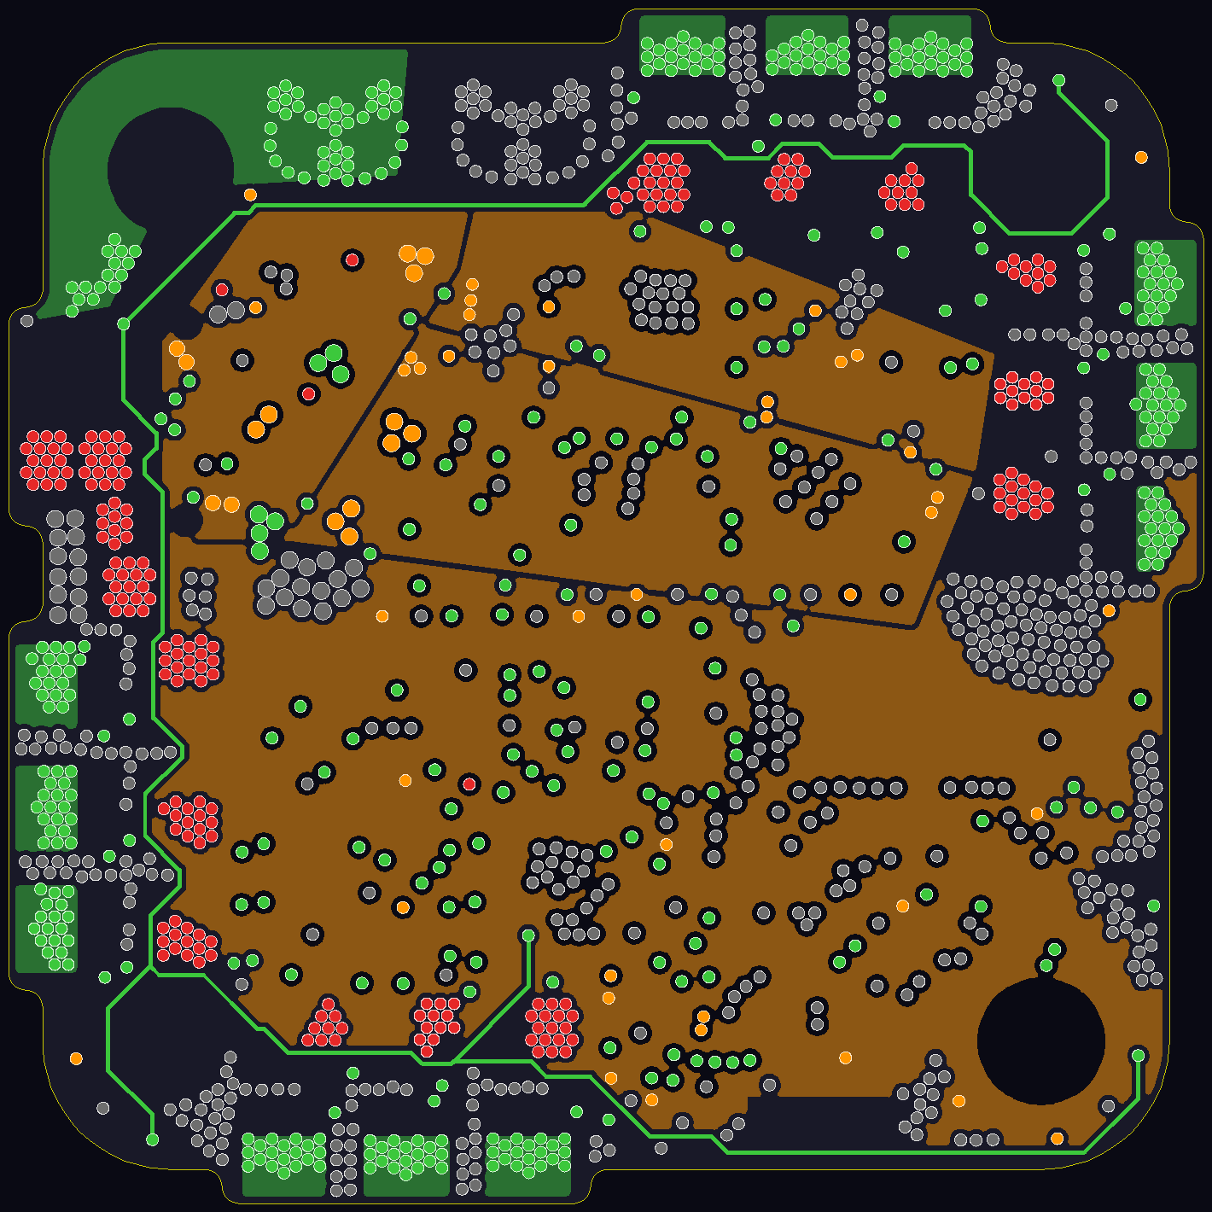
research/review-2026-10/lr_img/base_In3.Cu.png
