DroneAid-Parts/OpenAIO/research/review-2026-10/lr_img/core_In2.Cu.png

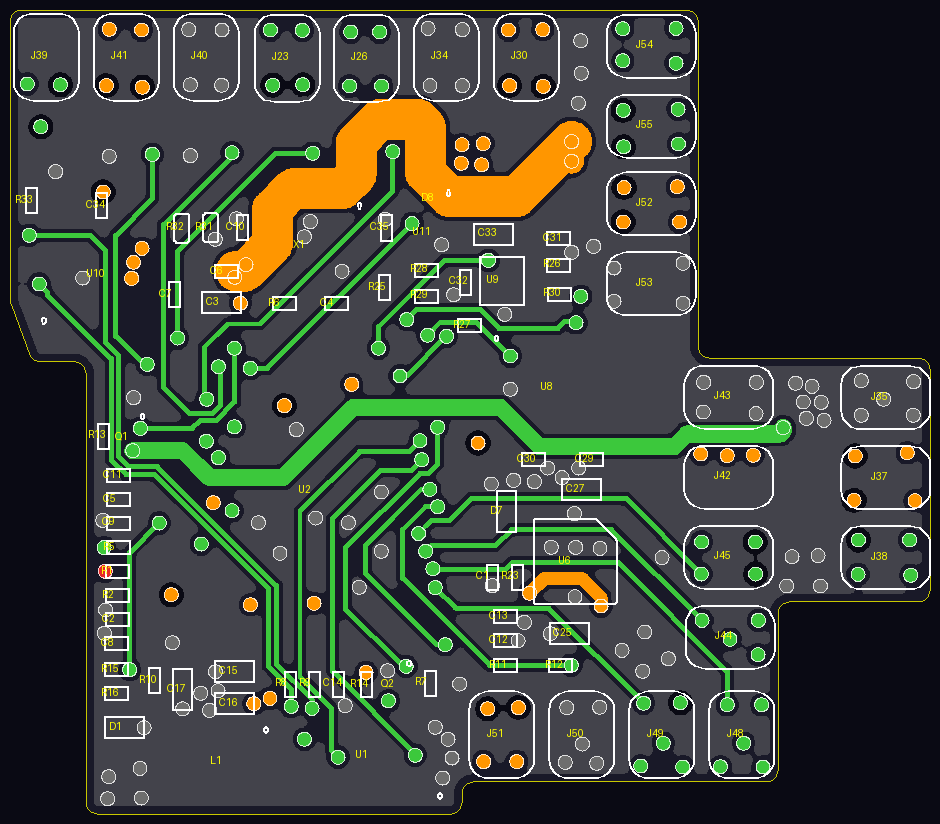
research/review-2026-10/lr_img/core_In2.Cu.png
