DroneAid-Parts/OpenAIO/research/review-2026-10/lr_img/crop_card.png

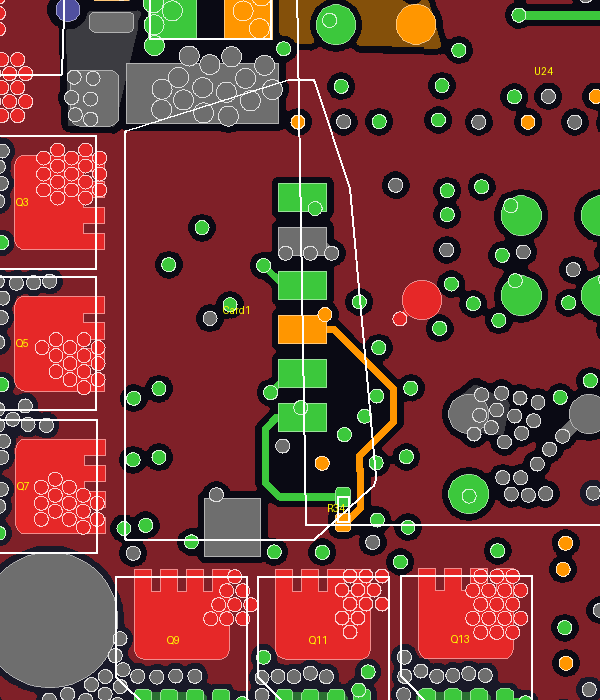
research/review-2026-10/lr_img/crop_card.png
