DroneAid-Parts/OpenAIO/research/review-2026-10/lr_img/J_batt.png

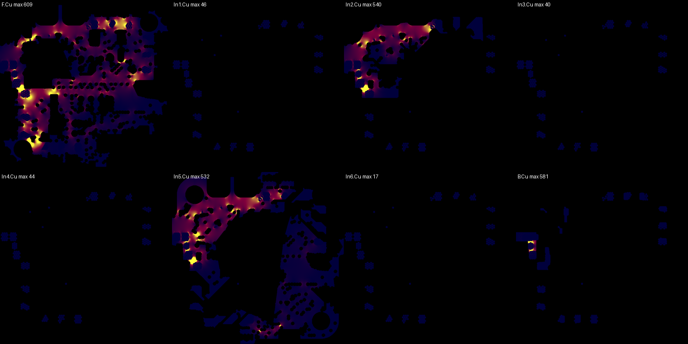
research/review-2026-10/lr_img/J_batt.png
