DroneAid-Parts/OpenAIO/research/review-2026-10/lr_img/J_csa.png

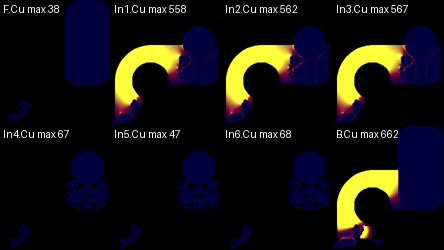
research/review-2026-10/lr_img/J_csa.png
