DroneAid-Parts/OpenAIO/research/review-2026-10/lr_img/lga_spec.png

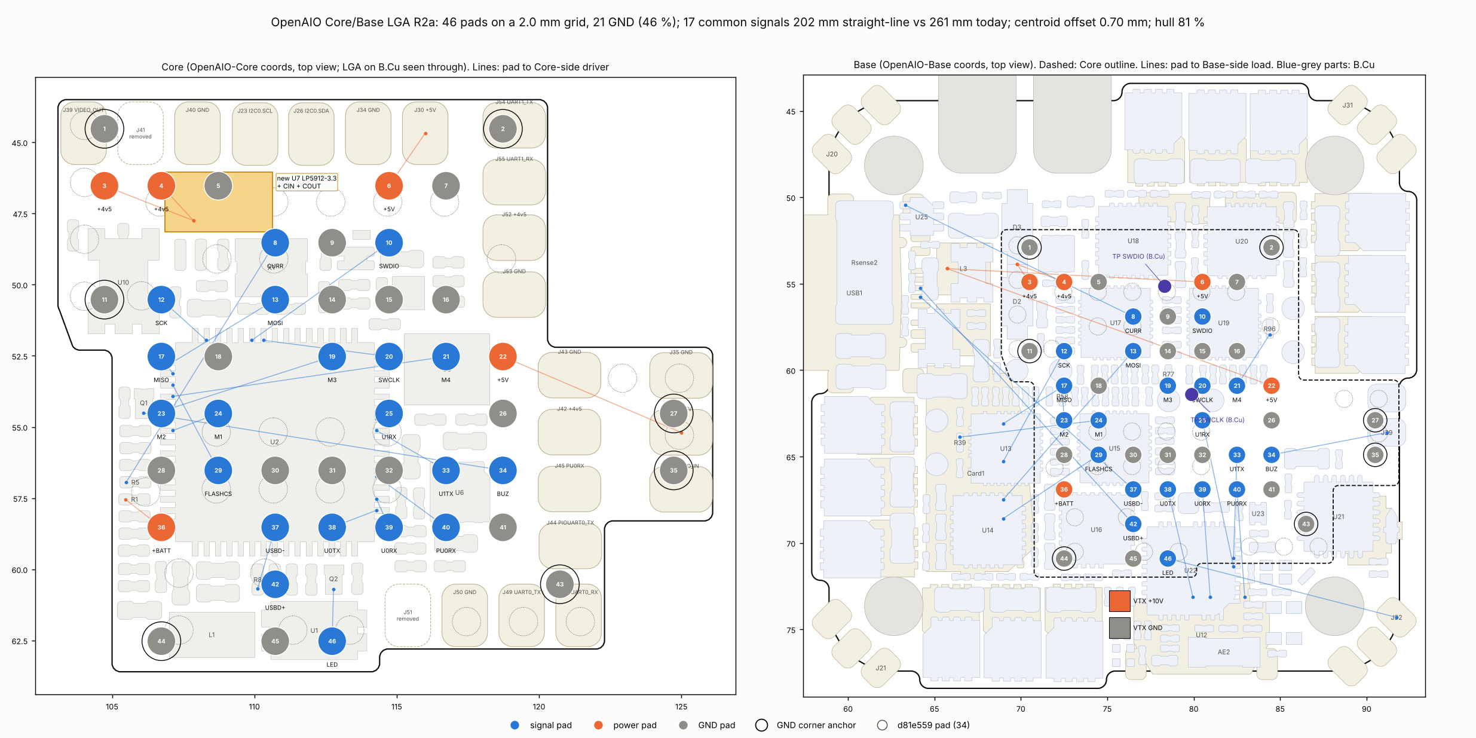
research/review-2026-10/lr_img/lga_spec.png
