DroneAid-Parts/OpenAIO/(list of files, drawings)

Other design files:
research/review-2026-10/schematic-review-2026-10-15.json
