DroneAid-Parts/OpenAIO/hardware/OpenAIO.kicad_pcb

## KiCad design hardware/OpenAIO.kicad_pcb (2026-10-15)

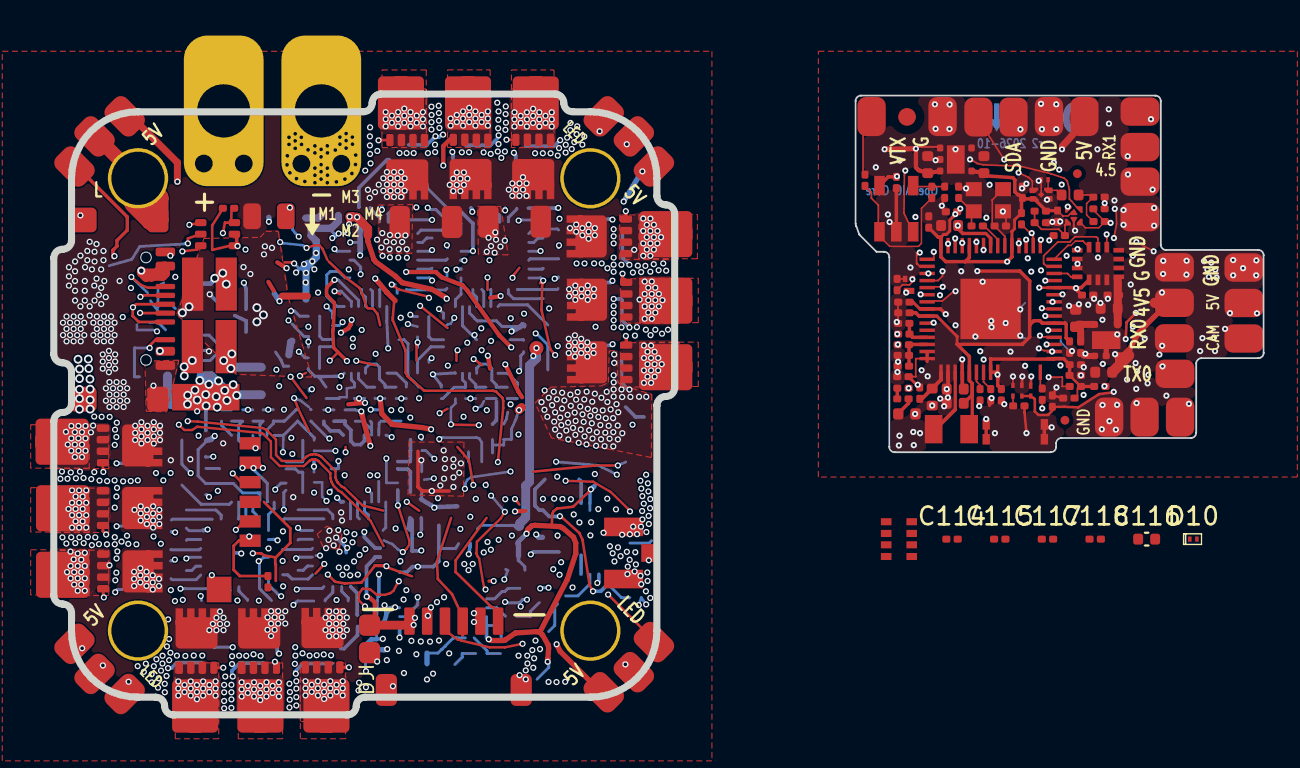
[picture p23: board OpenAIO.kicad_pcb from above]

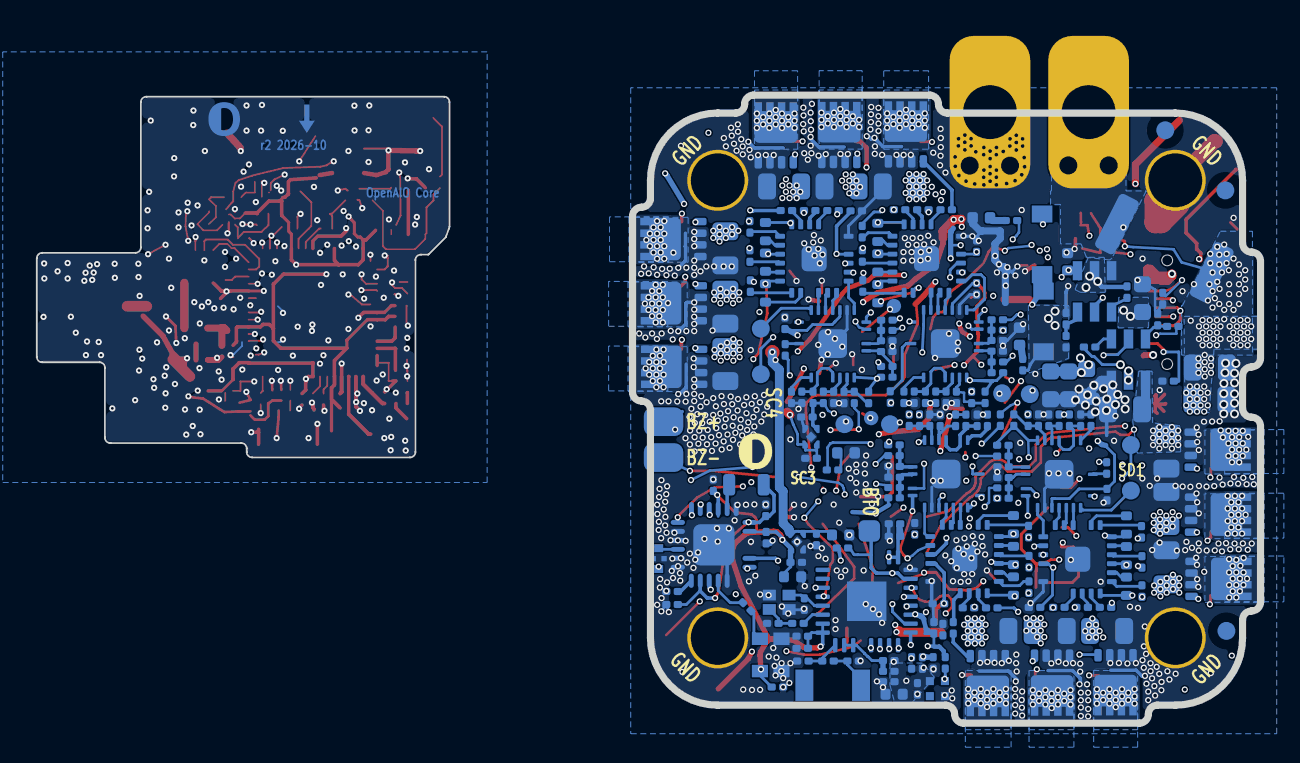
[picture p24: board OpenAIO.kicad_pcb from below]

Board: 8 copper layers, 68.2 x 35.0 mm, 362 parts (224 on the bottom side), 239 nets.

Parts:
AE2: 2450AT18A100E; ANT-SMD_L3.2-W1.6
C1, C2, C5, C6, C7, C8, C9, C11, C12, C13, C14, C20, C21, C29, C30, C32, C34, C35, C36, C108, C109, C114, C115, C117, C118: 100n; C_0201_0603Metric
C3, C15, C16, C17, C25, C27: 4.7uF; C_0402_1005Metric
C4, C10: 20p; C_0201_0603Metric
C18, C19, C90, C91, C92, C93, C94, C95, C96, C97, C98, C99, C100, C101, C102, C103: 4.7uF 50v; C_0805_2012Metric
C23, C24, C112, C113: 22uF; C_0603_1608Metric
C26, C28, C33: 1uF; C_0402_1005Metric
C31: 470p; C_0201_0603Metric
C37, C38, C39, C43, C44, C45, C46, C50, C51, C52, C53, C57, C58, C59, C60, C64, C65, C66, C70, C71, C76, C78, C79, C104: 100nF; C_0201_0603Metric
C40, C41, C42, C47, C48, C49, C54, C55, C56, C61, C62, C63: 100nF; C_0402_WIDE
C67, C73, C80: 10nF; C_0201_0603Metric
C68: 470nF; C_0201_0603Metric
C69: 1nF; C_0201_0603Metric
C72, C74: 15pF; C_0201_0603Metric
C75, C82, C88: 10uF; C_0402_1005Metric
C77, C81, C83, C84, C85, C86, C110, C111: 1uF; C_0201_0603Metric
C87, C89: 1.2pF; C_0201_0603Metric
C105, C106: 4.7uF 50v; C_1206_3216Metric
C107, C116: 100nF; C_0402_1005Metric
Card1: TF-021B-H265; TF-SMD_TF-021B-H265
D1: LED_1_Blue; LED_0402_1005Metric
D2, D3: DSK24; SOD-123_L2.8-W1.8-LS3.7-RD
D4, D5, D6, D7: LED_1_Green; LED_0402_1005Metric
D8, D10: SDM02U30LP3-7B; X3-DFN0603-2_L0.6-W0.3-RD
D9: XL-1010RGBC-WS2812B; LED-SMD_4P-L1.0-W1.0-TL_XL-1010RGBC-WS2812B
FID1, FID2, FID3, FID4: Fiducial_1mm_Mask2mm
FID5, FID6: Fiducial_1mm_Mask2mm; Fiducial_0.5mm_Mask1mm
FL1: 2450FM07D0034T; FILTER-SMD_4P-L1.0-W0.5-L
J15, J16, J24, J25, J30, J37: 5V; small_pad
J17, J18, J27, J28, J34, J35, J40, J43, J50, J53: GND; small_pad
J20, J21, J31, J32: LED; small_pad
J23: SCL; small_pad
J26: SDA; small_pad
J29: BUZ-; small_pad
J33: BUZ+; small_pad
J38: CAM; small_pad
J39: VTX; small_pad
J41: 10V; SolderPad_1.2x1.2mm
J42, J52: 4V5; small_pad
J44: PIO_TX0; small_pad
J45: PIO_RX0; small_pad
J48: RX0; small_pad
J49: TX0; small_pad
J51: GND; SolderPad_1.2x1.2mm
J54: TX1; small_pad
J55: RX1; small_pad
JP1: U.FL-R-SMT-1(80); RF-SMD_FRF05002-JSS103M
L1: AOTA-B201610S3R3-101-T; IND-SMD_L2.0-W1.6_AOTA-B201610S3R3-101-T
L2, L3: XRTC303020D4R7MBCA; IND-SMD_L3.0-W3.0_AFE303020S
L4: 15uH; L_0805_2012Metric
L5: 24nH; L_0201_0603Metric
L6: 2.0nH; L_0201_0603Metric
L7: 2.5nH; L_0201_0603Metric
OSC1: OW7EL89CENUNFAYLC-52M; OSC-SMD_4P-L2.0-W1.6-BL_TXC_7Z
Q1: AP1606; DFN-3L_L1.0-W0.6-P0.65-BR
Q3, Q4, Q5, Q6, Q7, Q8, Q9, Q10, Q11, Q12, Q13, Q14, Q15, Q16, Q17, Q18, Q19, Q20, Q21, Q22, Q23, Q24, Q25, Q26: DOY180N03T; DOY180N03T_TDFN3333-8
R1, R13, R17, R19: 100k; R_0201_0603Metric
R2, R25, R34, R37, R38, R45, R47, R48, R50, R51, R53, R56, R57, R64, R66, R67, R69, R70, R72, R75, R76, R83, R85, R86, R88, R89, R91, R94, R95, R102, R104, R105, R107, R108, R110, R111, R112, R113, R114: 10k; R_0201_0603Metric
R3, R4, R11, R12: 5.1k; R_0201_0603Metric
R5, R6, R7, R46, R49, R52, R65, R68, R71, R84, R87, R90, R103, R106, R109: 1k; R_0201_0603Metric
R8, R9, R10: 30R; R_0201_0603Metric
R15, R16, R26, R33: 75R; R_0201_0603Metric
R18, R23: 6.49k; R_0201_0603Metric
R20: 13.7k; R_0201_0603Metric
R21: 7.5k; R_0201_0603Metric
R22: 2.4k; R_0201_0603Metric
R24, R31, R32: 510R; R_0201_0603Metric
R27: 3.9k; R_0201_0603Metric
R28: 12k; R_0201_0603Metric
R29: 1.4k; R_0201_0603Metric
R30: 680R; R_0201_0603Metric
R35, R36, R41, R42, R43, R44, R54, R55, R60, R61, R62, R63, R73, R74, R79, R80, R81, R82, R92, R93, R98, R99, R100, R101: 15R; R_0201_0603Metric
R39, R58, R77, R96: 220R; R_0201_0603Metric
R40, R59, R78, R97: 10R; R_0201_0603Metric
R115: 200R; R_0201_0603Metric
Rsense2: 0.2mR; R_2512_6332Metric
TP1, TP2, TP3, TP4, TP5, TP6, TP7, TP8: TestPoint; TestPoint_Pad_D1.0mm
TP9: BOOT; SolderPad_1.2x2.0mm
TP31: SWDIO; TestPoint_Pad_D0.8mm
TP32: SWCLK; TestPoint_Pad_D0.8mm
U1: TS2306A 240GF MSM 9_C2976675; SW-SMD_4P-L3.0-W2.0-P0.85-LS3.5
U2: RP2354A; QFN-60_L7.0-W7.0-P0.40-TL-EP3.4
U3, U4: LMR51430YFDDCR; SOT-23-6_L2.9-W1.6-P0.95-LS2.9-BL
U6: LP5912-1.8DRVR; WSON-6-1EP_2x2mm_P0.65mm_EP1x1.6mm_ThermalVias
U7: LP5912-3.3DRVR; WSON-6-1EP_2x2mm_P0.65mm_EP1x1.6mm
U8: BMI270; LGA-14_L3.0-W2.5-P0.50-BR
U9: SN74LVC1G3157DTBR; X2SON-6_L1.0-W0.8-BL
U10: COS8051SOT; SOT-23-5_L3.0-W1.7-P0.95-LS2.8-BR
U11: TLV7031DPWR; X2SON-4_L0.8-W0.8-P0.48-TL-A
U12: SM06B-SRSS-TB(LF)(SN); CONN-SMD_SM06B-SRSS-TB-LF-SN
U13, U15, U17, U19: AT32F421G8U7; QFN-28_L4.0-W4.0-P0.40-TL-EP2.4
U14, U16, U18, U20: NSG2065Q; QFN-24_L4.0-W4.0-P0.50-TL-EP2.8
U21: SX1281IMLTRT; QFN-24_L4.0-W4.0-P0.50-TL-EP2.6
U22: ESP32-C3FH4; QFN-32-1EP_5x5mm_P0.5mm_EP3.7x3.7mm
U23, U27: TLV75533PDQNR; X2SON-4_L1.0-W1.0-P0.65-TL-EP
U24: AIO_outline
U25: INA186A3IDCKR; SOT-363_SC-70-6
U26: TXU0101DRYR; SON-6_L1.5-W1.0-P0.50-TL
U28: DPS368XTSA1; LGA-8_L2.5-W2.0-P0.65-TR_DPS368
USB1: TYPE-C 16P QTWT; USB-TYPE-C-SMD_TYPE-C-16P-QTWT
X1: XTM25012000JT00351001; CRYSTAL-SMD_4P-L2.5-W2.0-BL-A
X2: CJ17-400001010B20; CRYSTAL-SMD_4P-L1.6-W1.2-BL

Connections:
+1.1V: C1.1, C3.1, C5.1, C16.1, L1.1, U2.6 (DVDD), U2.23 (DVDD), U2.39 (DVDD), U2.50 (VREG_FB)
+1.8V_GYRO: C27.1, C29.1, U6.1 (OUT), U8.8 (Vdd)
+3.3V: C6.1, C7.1, C8.1, C11.1, C12.1, C13.1, C14.1, C15.1, C28.1, C30.1, C32.1, C34.1, C35.1, C36.1, C108.1, C114.1, C115.1, C117.1, C118.1, Card1.4 (VDD), R10.1, R11.1, R12.1, R25.2, R28.2, R34.1, U2.1 (IOVDD), U2.11 (IOVDD), U2.20 (IOVDD), U2.26 (RUN), U2.30 (IOVDD), U2.38 (IOVDD), U2.44 (ADC_AVDD), U2.45 (IOVDD), U2.49 (VREG_VIN), U2.53 (USB_OTP_VDD), U2.54 (QSPI_IOVDD), U7.1 (OUT), U8.2 (SDx/AH1/Qvar1), U8.3 (SCx/AH2/Qvar2), U8.5 (Vdd_IO), U9.5 (VCC), U10.5 (+VS), U11.2 (VCC), U26.1 (VCCA), U28.2 (CSB), U28.6 (VDDIO), U28.8 (VDD)
+3V3: C65.1, C66.1, C70.1, C71.1, C75.1, C76.1, C78.1, C79.1, C80.1, C81.1, C83.1, C86.1, C88.1, C104.1, L6.2, OSC1.4 (VDD), R24.1, R111.1, R112.1, R113.1, R114.2, U21.11 (VBAT_IO), U21.15 (VBAT), U22.11 (VDD3P3_RTC), U22.17 (VDD3P3_CPU), U22.18 (VDD_SPI), U22.31 (VDDA), U22.32 (VDDA), U23.1 (OUT), U25.3 (VS)
+3V3_ESC: C39.1, C46.1, C53.1, C60.1, C111.1, R37.2, R40.2, R56.2, R59.2, R75.2, R78.2, R94.2, R97.2, U13.17 (VDD), U15.17 (VDD), U17.17 (VDD), U19.17 (VDD), U27.1 (OUT)
+4v5: C25.1, C26.1, C82.1, C85.1, D2.1 (K), D3.1 (K), D9.2 (VDD), J42.1 (Pin_1_1), J52.1 (Pin_1_1), R23.1, U6.4 (EN), U6.6 (IN), U7.4 (EN), U7.6 (IN), U23.3 (EN), U23.4 (IN)
+5V: C24.1, C109.1, C110.1, D2.2 (A), D10.1 (C), J15.1 (Pin_1_1), J16.1 (Pin_1_1), J24.1 (Pin_1_1), J25.1 (Pin_1_1), J30.1 (Pin_1_1), J33.1 (Pin_1_1), J37.1 (Pin_1_1), L3.2, R19.2, R22.1, U26.5 (OE), U26.6 (VCCB), U27.3 (EN), U27.4 (IN)
+5V_USB: D3.2 (A), USB1.A4 (VBUS), USB1.A9 (VBUS)
+10V: C23.1, C43.1, C50.1, C57.1, C64.1, C112.1, C113.1, J41.1 (Pin_1_1), L2.2, R17.2, R21.1, U12.1, U14.4 (VCC), U16.4 (VCC), U18.4 (VCC), U20.4 (VCC)
+BATT: C18.1, C19.1, C90.1, C91.1, C92.1, C93.1, C94.1, C95.1, C96.1, C97.1, C98.1, C99.1, C100.1, C101.1, C102.1, C103.1, C105.1, C106.1, C107.1, C116.1, Q3.3 (D), Q5.3 (D), Q7.3 (D), Q9.3 (D), Q11.3 (D), Q13.3 (D), Q15.3 (D), Q17.3 (D), Q19.3 (D), Q21.3 (D), Q23.3 (D), Q25.3 (D), R1.2, Rsense2.2, U3.3 (VIN), U3.5 (EN), U4.3 (VIN), U4.5 (EN), U25.5 (-IN)
/1A: C40.1, Q3.1 (S), Q4.3 (D), R47.1, U14.18 (VS1), U24.12 (4A)
/1B: C41.1, Q5.1 (S), Q6.3 (D), R50.1, U14.15 (VS2), U24.13 (4B)
/1C: C42.1, Q7.1 (S), Q8.3 (D), R53.1, U14.12 (VS3), U24.14 (4C)
/2A: C47.1, Q9.1 (S), Q10.3 (D), R66.1, U16.18 (VS1), U24.15 (3B)
/2B: C48.1, Q11.1 (S), Q12.3 (D), R69.1, U16.15 (VS2), U24.16 (3C)
/2C: C49.1, Q13.1 (S), Q14.3 (D), R72.1, U16.12 (VS3), U24.17 (3A)
/3A: C54.1, Q15.1 (S), Q16.3 (D), R85.1, U18.18 (VS1), U24.20 (2B)
/3B: C55.1, Q17.1 (S), Q18.3 (D), R88.1, U18.15 (VS2), U24.19 (2C)
/3C: C56.1, Q19.1 (S), Q20.3 (D), R91.1, U18.12 (VS3), U24.18 (2A)
/4A: C61.1, Q21.1 (S), Q22.3 (D), R104.1, U20.18 (VS1), U24.23 (1A)
/4B: C62.1, Q23.1 (S), Q24.3 (D), R107.1, U20.15 (VS2), U24.22 (1B)
/4C: C63.1, Q25.1 (S), Q26.3 (D), R110.1, U20.12 (VS3), U24.21 (1C)
/CSA+: Rsense2.1, U24.1 (VBAT), U25.4 (+IN)
/ESC1/AH: U13.20 (PA10), U14.22 (HIN1)
/ESC1/AL: U13.15 (PB1), U14.1 (LIN1)
/ESC1/BH: U13.19 (PA9), U14.23 (HIN2)
/ESC1/BL: U13.14 (PB0), U14.2 (LIN2)
/ESC1/CH: U13.18 (PA8), U14.24 (HIN3)
/ESC1/CL: U13.13 (PA7), U14.3 (LIN3)
/ESC1/FBA: R45.1, R46.2, R47.2, U13.6 (PA0)
/ESC1/FBB: R48.2, R49.2, R50.2, U13.10 (PA4)
/ESC1/FBC: R51.2, R52.2, R53.2, U13.11 (PA5)
/ESC1/FBCOMMON: R45.2, R48.1, R51.1, U13.7 (PA1)
/ESC1/GHA: R35.1, U14.19 (HO1)
/ESC1/GHB: R41.1, U14.16 (HO2)
/ESC1/GHC: R43.1, U14.13 (HO3)
/ESC1/GLA: R36.1, U14.11 (LO1)
/ESC1/GLB: R42.1, U14.10 (LO2)
/ESC1/GLC: R44.1, U14.9 (LO3)
/ESC1/vdda: C38.1, R40.1, U13.5 (VDDA)
/ESC2/AH: U15.20 (PA10), U16.22 (HIN1)
/ESC2/AL: U15.15 (PB1), U16.1 (LIN1)
/ESC2/BH: U15.19 (PA9), U16.23 (HIN2)
/ESC2/BL: U15.14 (PB0), U16.2 (LIN2)
/ESC2/CH: U15.18 (PA8), U16.24 (HIN3)
/ESC2/CL: U15.13 (PA7), U16.3 (LIN3)
/ESC2/FBA: R64.1, R65.2, R66.2, U15.6 (PA0)
/ESC2/FBB: R67.2, R68.2, R69.2, U15.10 (PA4)
/ESC2/FBC: R70.2, R71.2, R72.2, U15.11 (PA5)
/ESC2/FBCOMMON: R64.2, R67.1, R70.1, U15.7 (PA1)
/ESC2/GHA: R54.1, U16.19 (HO1)
/ESC2/GHB: R60.1, U16.16 (HO2)
/ESC2/GHC: R62.1, U16.13 (HO3)
/ESC2/GLA: R55.1, U16.11 (LO1)
/ESC2/GLB: R61.1, U16.10 (LO2)
/ESC2/GLC: R63.1, U16.9 (LO3)
/ESC2/vdda: C45.1, R59.1, U15.5 (VDDA)
/ESC3/AH: U17.20 (PA10), U18.22 (HIN1)
/ESC3/AL: U17.15 (PB1), U18.1 (LIN1)
/ESC3/BH: U17.19 (PA9), U18.23 (HIN2)
/ESC3/BL: U17.14 (PB0), U18.2 (LIN2)
/ESC3/CH: U17.18 (PA8), U18.24 (HIN3)
/ESC3/CL: U17.13 (PA7), U18.3 (LIN3)
/ESC3/FBA: R83.1, R84.2, R85.2, U17.6 (PA0)
/ESC3/FBB: R86.2, R87.2, R88.2, U17.10 (PA4)
/ESC3/FBC: R89.2, R90.2, R91.2, U17.11 (PA5)
/ESC3/FBCOMMON: R83.2, R86.1, R89.1, U17.7 (PA1)
/ESC3/GHA: R73.1, U18.19 (HO1)
/ESC3/GHB: R79.1, U18.16 (HO2)
/ESC3/GHC: R81.1, U18.13 (HO3)
/ESC3/GLA: R74.1, U18.11 (LO1)
/ESC3/GLB: R80.1, U18.10 (LO2)
/ESC3/GLC: R82.1, U18.9 (LO3)
/ESC3/vdda: C52.1, R78.1, U17.5 (VDDA)
/ESC4/AH: U19.20 (PA10), U20.22 (HIN1)
/ESC4/AL: U19.15 (PB1), U20.1 (LIN1)
/ESC4/BH: U19.19 (PA9), U20.23 (HIN2)
/ESC4/BL: U19.14 (PB0), U20.2 (LIN2)
/ESC4/CH: U19.18 (PA8), U20.24 (HIN3)
/ESC4/CL: U19.13 (PA7), U20.3 (LIN3)
/ESC4/FBA: R102.1, R103.2, R104.2, U19.6 (PA0)
/ESC4/FBB: R105.2, R106.2, R107.2, U19.10 (PA4)
/ESC4/FBC: R108.2, R109.2, R110.2, U19.11 (PA5)
/ESC4/FBCOMMON: R102.2, R105.1, R108.1, U19.7 (PA1)
/ESC4/GHA: R92.1, U20.19 (HO1)
/ESC4/GHB: R98.1, U20.16 (HO2)
/ESC4/GHC: R100.1, U20.13 (HO3)
/ESC4/GLA: R93.1, U20.11 (LO1)
/ESC4/GLB: R99.1, U20.10 (LO2)
/ESC4/GLC: R101.1, U20.9 (LO3)
/ESC4/vdda: C59.1, R97.1, U19.5 (VDDA)
/IMU/CS: R25.1, U2.17 (GPIO13), U8.12 (CS)
/IMU/GYRO_INT: U2.13 (GPIO9), U8.4 (INT1)
/IMU/SPI1.MISO: U2.16 (GPIO12), U8.1 (SDO/SA0)
/IMU/SPI1.MOSI: U2.15 (GPIO11), U8.14 (SDA)
/IMU/SPI1.SCK: U2.14 (GPIO10), U8.13 (SCL)
/OSD/OSD_EN: U2.19 (GPIO15), U9.6 (S)
/OSD/OSD_LVL: R27.2, R28.1, R29.2, U9.1 (B2)
/OSD/OSD_SYNC: U2.27 (GPIO16), U11.1 (OUT)
/OSD/OSD_W: R27.1, U2.18 (GPIO14)
/OSD/VIDEO_IN: J38.1 (Pin_1_1), R26.1, R30.2, U9.3 (B1)
/OSD/VIDEO_OUT: J39.1 (Pin_1_1), R33.2
/OSD/VID_DC: C33.2, D8.1 (C), U11.4 (IN+)
/OSD/VID_FILT: C31.1, C33.1, R30.1
/Pads/I2C0.SCL: J23.1 (Pin_1_1), R11.2, U2.8 (GPIO5), U28.4 (SCK)
/Pads/I2C0.SDA: J26.1 (Pin_1_1), R12.2, U2.7 (GPIO4), U28.3 (SDI)
/Pads/PIOUART0_TX: J44.1 (Pin_1_1), U2.4 (GPIO2)
/Power/1.8V_PG: D7.2 (A), R23.2, U6.3 (PG)
/RP2354A/ADC_VBAT: C2.2, R1.1, R2.2, U2.43 (GPIO29_ADC3)
/RP2354A/BEEPER: Q1.1 (G), R13.2, U2.28 (GPIO17)
/RP2354A/ESC_CURR: C9.1, R5.2, U2.42 (GPIO28_ADC2)
/RP2354A/LED0: R15.1, U2.40 (GPIO26_ADC0)
/RP2354A/LED_STRIP_L: U2.12 (GPIO8), U26.3 (A)
/RP2354A/XIN: C4.2, U2.21 (XIN), X1.1
/RP2354A/XOUT: R6.1, U2.22 (XOUT)
/RX/BOOT: R113.2, TP9.1 (1_1), U22.15 (GPIO9)
/RX/BUSY: U21.7 (BUSY), U22.8 (GPIO3)
/RX/CHIP_EN: C84.1, R114.1, U22.7 (CHIP_EN)
/RX/DIO1: U21.8 (DIO1), U22.5 (XTAL_32K_N)
/RX/LED: D9.4 (DIN), R112.2, U22.14 (GPIO8)
/RX/MISO: U21.16 (MISO_TX), U22.10 (MTDI)
/RX/MOSI: U21.17 (MOSI_RX), U22.9 (MTMS)
/RX/NSS: U21.19 (NSS_CTS), U22.13 (MTDO)
/RX/RST: R111.2, U21.3 (NRESET), U22.6 (GPIO2)
/RX/SCK: U21.18 (SCK_RTSN), U22.12 (MTCK)
/RX/WIFI: AE2.1, C89.1, L7.1
/RX/XTAL_N: C74.1, U22.29 (XTAL_N), X2.3
/RX/XTAL_P: L5.2, U22.30 (XTAL_P)
BUZZER-: D10.2 (A), J29.1 (Pin_1_1), Q1.3 (D)
CURR: R5.1, U25.6 (OUT)
GND: C1.2, C2.1, C3.2, C4.1, C5.2, C6.2, C7.2, C8.2, C9.2, C10.1, C11.2, C12.2, C13.2, C14.2, C15.2, C16.2, C17.2, C18.2, C19.2, C23.2, C24.2, C25.2, C26.2, C27.2, C28.2, C29.2, C30.2, C31.2, C32.2, C34.2, C35.2, C36.2, C37.2, C38.2, C39.2, C43.2, C44.2, C45.2, C46.2, C50.2, C51.2, C52.2, C53.2, C57.2, C58.2, C59.2, C60.2, C64.2, C65.2, C66.2, C67.1, C68.1, C70.2, C71.2, C72.2, C73.2, C74.2, C75.2, C76.2, C77.2, C78.2, C79.2, C80.2, C81.2, C82.2, C83.2, C84.2, C85.2, C86.2, C87.2, C88.2, C89.2, C90.2, C91.2, C92.2, C93.2, C94.2, C95.2, C96.2, C97.2, C98.2, C99.2, C100.2, C101.2, C102.2, C103.2, C104.2, C105.2, C106.2, C107.2, C108.2, C109.2, C110.2, C111.2, C112.2, C113.2, C114.2, C115.2, C116.2, C117.2, C118.2, Card1.6 (VSS), Card1.9, Card1.10, D1.1 (K), D4.1 (K), D5.1 (K), D6.1 (K), D7.1 (K), D8.2 (A), D9.3 (GND), FL1.2 (GND), FL1.4 (GND), J17.1 (Pin_1_1), J18.1 (Pin_1_1), J27.1 (Pin_1_1), J28.1 (Pin_1_1), J34.1 (Pin_1_1), J35.1 (Pin_1_1), J40.1 (Pin_1_1), J43.1 (Pin_1_1), J50.1 (Pin_1_1), J51.1 (Pin_1_1), J53.1 (Pin_1_1), JP1.2 (GND), JP1.3 (GND), OSC1.1 (GND), OSC1.2 (GND), Q1.2 (S), Q4.1 (S), Q6.1 (S), Q8.1 (S), Q10.1 (S), Q12.1 (S), Q14.1 (S), Q16.1 (S), Q18.1 (S), Q20.1 (S), Q22.1 (S), Q24.1 (S), Q26.1 (S), R2.1, R3.1, R4.1, R13.1, R18.2, R20.2, R26.2, R29.1, R31.2, R38.2, R46.1, R49.1, R52.1, R57.2, R65.1, R68.1, R71.1, R76.2, R84.1, R87.1, R90.1, R95.2, R103.1, R106.1, R109.1, U1.1, U2.47 (VREG_PGND), U2.61 (EP), U3.1 (GND), U4.1 (GND), U6.5 (GND), U6.7 (EP), U7.3 (PG), U7.5 (GND), U7.7 (EP), U8.6 (GND), U8.7 (GND), U9.2 (GND), U10.2 (-VS), U11.3 (IN-), U11.5 (VEE), U12.2, U12.5, U12.7, U12.8, U13.16 (VSS), U13.29 (VSS), U14.6 (COM), U14.25 (COM), U15.16 (VSS), U15.29 (VSS), U16.6 (COM), U16.25 (COM), U17.16 (VSS), U17.29 (VSS), U18.6 (COM), U18.25 (COM), U19.16 (VSS), U19.29 (VSS), U20.6 (COM), U20.25 (COM), U21.5 (GND), U21.13 (GND), U21.20 (GND), U21.21 (GND), U21.23 (GND), U21.24 (GND), U21.25 (EP), U22.16 (GPIO10), U22.33 (GND), U23.2 (GND), U23.5 (EP), U24.2 (BATGND), U24.11 (Hole), U25.1 (REF), U25.2 (GND), U26.2 (GND), U27.2 (GND), U27.5 (EP), U28.1 (GND), U28.5 (SDO), U28.7 (GND), USB1.0 (EH), USB1.A1 (GND), USB1.A12 (GND), X1.2 (GND), X1.4 (GND), X2.2 (GND), X2.4 (GND)
LED_STRIP: J20.1 (Pin_1_1), J21.1 (Pin_1_1), J31.1 (Pin_1_1), J32.1 (Pin_1_1), R115.2
MOTOR1: R39.1, U2.37 (GPIO25)
MOTOR2: R58.1, U2.36 (GPIO24)
MOTOR3: R77.1, U2.35 (GPIO23)
MOTOR4: R96.1, U2.34 (GPIO22)
unnamed: C10.2, R6.2, X1.3
unnamed: C72.1, L5.1, X2.1
unnamed: C77.1, L6.1, U22.2 (VDD3P3), U22.3 (VDD3P3)
unnamed: D1.2 (A), R16.2
unnamed: D4.2 (A), R21.2
unnamed: D5.2 (A), R22.2
unnamed: D6.2 (A), R24.2
unnamed: FL1.1 (IN), U21.22 (RFIO)
unnamed: FL1.3 (OUT), JP1.1 (SIG)
unnamed: C69.1, OSC1.3 (Out_Put)
unnamed: Q3.2 (G), R35.2
unnamed: Q4.2 (G), R36.2
unnamed: Q5.2 (G), R41.2
unnamed: Q6.2 (G), R42.2
unnamed: Q7.2 (G), R43.2
unnamed: Q8.2 (G), R44.2
unnamed: Q9.2 (G), R54.2
unnamed: Q10.2 (G), R55.2
unnamed: Q11.2 (G), R60.2
unnamed: Q12.2 (G), R61.2
unnamed: Q13.2 (G), R62.2
unnamed: Q14.2 (G), R63.2
unnamed: Q15.2 (G), R73.2
unnamed: Q16.2 (G), R74.2
unnamed: Q17.2 (G), R79.2
unnamed: Q18.2 (G), R80.2
unnamed: Q19.2 (G), R81.2
unnamed: Q20.2 (G), R82.2
unnamed: Q21.2 (G), R92.2
unnamed: Q22.2 (G), R93.2
unnamed: Q23.2 (G), R98.2
unnamed: Q24.2 (G), R99.2
unnamed: Q25.2 (G), R100.2
unnamed: Q26.2 (G), R101.2
unnamed: R7.1, U1.2
unnamed: R15.2, R16.1
unnamed: R7.2, U2.60 (QSPI_SS)
unnamed: R8.2, U2.51 (USB_DM)
unnamed: R9.1, U2.52 (USB_DP)
unnamed: C17.1, R10.2, U2.46 (VREG_AVDD)
unnamed: L1.2, U2.48 (VREG_LX)
unnamed: C20.2, U3.6 (CB)
unnamed: R17.1, R18.1, U3.4 (FB)
unnamed: C20.1, L2.1, U3.2 (SW)
unnamed: C21.2, U4.6 (CB)
unnamed: R19.1, R20.1, U4.4 (FB)
unnamed: C21.1, L3.1, U4.2 (SW)
unnamed: U9.4 (A), U10.3 (IN+)
unnamed: R31.1, R32.1, U10.4 (IN-)
unnamed: R32.2, R33.1, U10.1 (OUT)
unnamed: R38.1, U13.1 (BOOT0)
unnamed: C37.1, R37.1, U13.4 (NRST)
unnamed: TP1.1 (1_1), U13.21 (PA13)
unnamed: TP2.1 (1_1), U13.22 (PA14)
unnamed: R39.2, U13.25 (PB4)
unnamed: C40.2, U14.20 (VB1)
unnamed: C41.2, U14.17 (VB2)
unnamed: C42.2, U14.14 (VB3)
unnamed: R57.1, U15.1 (BOOT0)
unnamed: C44.1, R56.1, U15.4 (NRST)
unnamed: TP3.1 (1_1), U15.21 (PA13)
unnamed: TP4.1 (1_1), U15.22 (PA14)
unnamed: R58.2, U15.25 (PB4)
unnamed: C47.2, U16.20 (VB1)
unnamed: C48.2, U16.17 (VB2)
unnamed: C49.2, U16.14 (VB3)
unnamed: R76.1, U17.1 (BOOT0)
unnamed: C51.1, R75.1, U17.4 (NRST)
unnamed: TP5.1 (1_1), U17.21 (PA13)
unnamed: TP6.1 (1_1), U17.22 (PA14)
unnamed: R77.2, U17.25 (PB4)
unnamed: C54.2, U18.20 (VB1)
unnamed: C55.2, U18.17 (VB2)
unnamed: C56.2, U18.14 (VB3)
unnamed: R95.1, U19.1 (BOOT0)
unnamed: C58.1, R94.1, U19.4 (NRST)
unnamed: TP7.1 (1_1), U19.21 (PA13)
unnamed: TP8.1 (1_1), U19.22 (PA14)
unnamed: R96.2, U19.25 (PB4)
unnamed: C61.2, U20.20 (VB1)
unnamed: C62.2, U20.17 (VB2)
unnamed: C63.2, U20.14 (VB3)
unnamed: C67.2, C68.2, L4.1, U21.2 (VDD_IN), U21.12 (DCC_FB)
unnamed: L4.2, U21.14 (DCC_SW)
unnamed: C73.1, U21.1 (VR_PA)
unnamed: C69.2, U21.4 (XTA)
unnamed: C87.1, L7.2, U22.1 (LNA_IN)
unnamed: R115.1, U26.4 (BY)
unnamed: R3.2, USB1.A5 (CC1)
unnamed: R4.2, USB1.B5 (CC2)
PU0RX: J45.1 (Pin_1_1), U2.5 (GPIO3), U12.6
SD_CS: Card1.2 (CD/DAT3), R34.2, U2.33 (GPIO21)
SPI0.MISO: Card1.7 (DAT0), U2.32 (GPIO20)
SPI0.MOSI: Card1.3 (CMD), U2.31 (GPIO19)
SPI0.SCK: Card1.5 (CLX), U2.29 (GPIO18)
SWCLK: TP32.1 (1_1), U2.24 (SWCLK)
SWDIO: TP31.1 (1_1), U2.25 (SWDIO)
UART0_RX: J48.1 (Pin_1_1), U2.3 (GPIO1), U12.4
UART0_TX: J49.1 (Pin_1_1), U2.2 (GPIO0), U12.3
UART1_RX: J55.1 (Pin_1_1), U2.10 (GPIO7), U22.28 (U0TXD)
UART1_TX: J54.1 (Pin_1_1), U2.9 (GPIO6), U22.27 (U0RXD)
USB_D+: R9.2, USB1.A6 (DP1), USB1.B6 (DP2)
USB_D-: R8.1, USB1.A7 (DN1), USB1.B7 (DN2)
