DroneAid-Parts/OpenAIO/research/review-2026-10/firmware/betaflight/OPENAIO/config.h

#pragma once
#define FC_TARGET_MCU        RP2350A      // RP2354A = RP2350A die + 2 MB W25Q16JV flash die (RP2350.pdf p1331)
#define BOARD_NAME           OPENAIO
#define MANUFACTURER_ID      OPDR         // PLACEHOLDER: needs a registered 4-char ID before upstreaming
#define USE_GYRO
#define USE_ACC
#define USE_ACCGYRO_BMI270
#define SPI1_SCK_PIN         PA10         // /IMU/SPI1.SCK  | U2.14 | Core only | U8.13 SCx
#define SPI1_SDI_PIN         PA12         // /IMU/SPI1.MISO | U2.16 | Core only | U8.1 SDO
#define SPI1_SDO_PIN         PA11         // /IMU/SPI1.MOSI | U2.15 | Core only | U8.14 SDx
#define GYRO_1_SPI_INSTANCE  SPI1
#define GYRO_1_CS_PIN        PA13         // /IMU/CS        | U2.17 | Core only | U8.12 CSB, R25 10k pull-up to +3.3V
#define GYRO_1_EXTI_PIN      PA9          // /IMU/GYRO_INT  | U2.13 | Core only | U8.4 INT1
#define GYRO_2_CS_PIN        NONE
#define GYRO_1_ALIGN         CW180_DEG
#define USE_SDCARD
#define USE_SDCARD_SPI
#define SPI0_SCK_PIN         PA18         // SPI0.SCK  | U2.29 | LGA 12 | Card1.5 CLK
#define SPI0_SDI_PIN         PA20         // SPI0.MISO | U2.32 | LGA 17 | Card1.7 DAT0
#define SPI0_SDO_PIN         PA19         // SPI0.MOSI | U2.31 | LGA 13 | Card1.3 CMD
#define SDCARD_SPI_INSTANCE  SPI0
#define SDCARD_SPI_CS_PIN    PA21         // SD_CS     | U2.33 | Card1.2 CD/DAT3, R34 10k pull-up to +3.3V (card on the FC rail since 2026-10-15).
#define SDCARD_DETECT_PIN    NONE         // no card-detect switch is wired
#define DEFAULT_BLACKBOX_DEVICE BLACKBOX_DEVICE_SDCARD
#define MOTOR1_PIN           PA25         // MOTOR1 | U2.37 | LGA 24 | R39 220R -> U13 (ESC1) PB4
#define MOTOR2_PIN           PA24         // MOTOR2 | U2.36 | LGA 23 | R58 220R -> U15 (ESC2) PB4
#define MOTOR3_PIN           PA23         // MOTOR3 | U2.35 | LGA 19 | R77 220R -> U17 (ESC3) PB4
#define MOTOR4_PIN           PA22         // MOTOR4 | U2.34 | LGA 21 | R96 220R -> U19 (ESC4) PB4
#define DEFAULT_DSHOT_TELEMETRY DSHOT_TELEMETRY_ON   // AM32 answers bidirectional DShot
#define UART1_TX_PIN         PA6          // UART1_TX | U2.9  | LGA 33 | U22.27 U0RXD (ESP32-C3 GPIO20); J54 "TX1" (Core)
#define UART1_RX_PIN         PA7          // UART1_RX | U2.10 | LGA 25 | U22.28 U0TXD (ESP32-C3 GPIO21); J55 "RX1" (Core)
#define DEFAULT_RX_FEATURE   FEATURE_RX_SERIAL
#define SERIALRX_PROVIDER    SERIALRX_CRSF
#define SERIALRX_UART        SERIAL_PORT_UART1
#define UART0_TX_PIN         PA2          // /Pads/PIOUART0_TX | U2.4 | Core only | J44 "PIO_TX0"
#define UART0_RX_PIN         PA3          // PU0RX             | U2.5 | LGA 40    | U12.6 (SH-6 pin 6, SBUS); J45 "PIO_RX0" (Core)
#define PIOUART0_TX_PIN      PA0          // UART0_TX | U2.2 | LGA 38 | U12.3 (SH-6 pin 3); J49 "TX0" (Core)
#define PIOUART0_RX_PIN      PA1          // UART0_RX | U2.3 | LGA 39 | U12.4 (SH-6 pin 4); J48 "RX0" (Core)
#define MSP_DISPLAYPORT_UART SERIAL_PORT_PIOUART0
#define PIO_LEDSTRIP_INDEX   1
#define I2C0_SDA_PIN         PA4          // /Pads/I2C0.SDA | U2.7 | U28.3, J26 "SDA", R12 5.1k pull-up to +3.3V
#define I2C0_SCL_PIN         PA5          // /Pads/I2C0.SCL | U2.8 | U28.4, J23 "SCL", R11 5.1k pull-up to +3.3V
#define MAG_I2C_INSTANCE     I2CDEV_0
#define BARO_I2C_INSTANCE    I2CDEV_0
#define USE_BARO
#define USE_BARO_DPS310                   // DPS368 is register compatible with the DPS310 driver
#define ADC_VBAT_PIN         PA29         // /RP2354A/ADC_VBAT | U2.43 (ADC3) | +BATT via LGA 36 | R1 100k / R2 10k, C2 100n (Core)
#define ADC_CURR_PIN         PA28         // /RP2354A/ESC_CURR | U2.42 (ADC2) | CURR via LGA 8 | R5 1k + C9 100n (Core) <- U25.6 INA186A3 OUT (Base)
#define DEFAULT_VOLTAGE_METER_SOURCE VOLTAGE_METER_ADC
#define DEFAULT_CURRENT_METER_SOURCE CURRENT_METER_ADC
#define DEFAULT_VOLTAGE_METER_SCALE  110
#define DEFAULT_CURRENT_METER_SCALE  200
#define DEFAULT_CURRENT_METER_OFFSET 0
#define USE_BEEPER
#define BEEPER_PIN           PA17         // /RP2354A/BEEPER | U2.28 | Q1 AP1606 gate, R13 100k pull-down (Core);
#define BEEPER_INVERTED
#define LED0_PIN             PA26         // /RP2354A/LED0 | U2.40 | Core only | R15 75R + R16 75R -> D1 (blue) anode, cathode GND
#define LED0_INVERTED                     // LED is active-high; Betaflight's default drives LEDs active-low
#define LED_STRIP_PIN        PA8          // /RP2354A/LED_STRIP_L | U2.12 | (Q2 today, TXU0101 planned) -> LED_STRIP
#define ENABLE_FB_OSD        1
#if ENABLE_FB_OSD
#define USE_OSD_SD
#define OSD_W_PIN            PA14         // /OSD/OSD_W    | U2.18 | Core only | R27 3.9k -> /OSD/OSD_LVL -> U9.1 B2
#define OSD_EN_PIN           PA15         // /OSD/OSD_EN   | U2.19 | Core only | U9.6 S (SN74LVC1G3157)
#define OSD_SYNC_PIN         PA16         // /OSD/OSD_SYNC | U2.27 | Core only | U11.1 TLV7031 OUT (push-pull)
#define OSD_FB_PICO_FLASH_FONT
#define OSD_FB_PICO_ENABLE_PIXEL_MODE 1
#if OSD_FB_PICO_ENABLE_PIXEL_MODE
#define OSD_FB_PICO_POSTPROCESS 2
#define OSD_BATTERY_PERCENT_WITH_SYMBOL
#define OSD_RSSI_WITH_SYMBOL
#define OSD_FB_ENABLE_SMALLFONT 1
#endif // OSD_FB_PICO_ENABLE_PIXEL_MODE
#if !OSD_FB_ENABLE_SMALLFONT
#undef OSD_RSSI_WITH_SYMBOL
#endif
#define OSD_FRAMERATE_MAX_HZ         100
#define OSD_FRAMERATE_DEFAULT_HZ     50
#define OSD_DRAWSCREEN_TIME_LIMIT_US 20
#endif // ENABLE_FB_OSD
#define DEFAULT_FEATURES     (FEATURE_OSD | FEATURE_TELEMETRY | FEATURE_LED_STRIP)
