DroneAid-Parts/OpenAIO/(commit log)

2026-10-12 docs(agents): cut AGENTS.md to validate, boundaries, pointers (#19)
    AGENTS.md 119 -> 22 lines. Removes architecture, tables, procedures and
    state; keeps only hard boundaries and the validation command.
    Claude-Session: https://claude.ai/code/session_017Ye54fa9v5VP179Xbw465R
2026-10-13 docs: restore AGENTS.md technical write-up (#20)
    Reverts the AGENTS.md cut and the README pointer change; the write-up is board documentation, not duplicated elsewhere.
    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
2026-10-15 One board: Base + Core merged on the 8L HDI stackup, replaces the OpenFC-Core module layout (#25)
    * Base fully routed (recovered from KiCad local history, 2026-08-22)
    The finished Base route was never committed: the last Base commit (ce0aa59)
    had 57 unconnected. Recovered from hardware/.history snapshot 55d048e
    (last save 2026-08-22 15:03), on top of ce0aa59.
    DRC (kicad-cli 10):
    - Base: 0 unconnected, 0 shorts, 6 errors (3 x U23 own pad-to-pad
    clearance, USB1 NPTH: 1 clearance + 2 annular width), 111 warnings
    - Core: 0 unconnected, 0 errors
    * Power: +10V buck always on with battery, 10V_ENABLE removed
    CIRCUIT_REVIEW B1: the LMR51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
    [OpenAIO.kicad_pcb, OpenAIO.kicad_sch, esc_channel.kicad_sch, esp32c3_lr1121_mono.kicad_sch, fc_blackbox.kicad_sch, fc_imu.kicad_sch, fc_osd.kicad_sch, fc_pads.kicad_sch]
2026-10-15 Apply DroneAid rebrand and configure upstream sync
    [OpenAIO.kicad_pcb]
