DroneAid-Parts/OpenAIO/(notices)

Notices in the files:
research/review-2026-10/firmware/betaflight/OPENAIO/config.h:
Public License as published by the Free Software Foundation,
either version 3 of the License, or (at your option) any later
